j-glow/naped_manipulatora/Modele3d/nakladka/PerformanceLog.txt

Number of Contacts: 0
Number of contact data: 0
