j-glow/naped_manipulatora/Sprawozdanie.docx

# Zakład Podstaw Kontrukcji

# ITLiMS, MEiL, PW

Podstawy Konstrukcji Robotów

Rok akademicki 2022/2023, semestr zimowy

Napęd manipulatora

Sprawozdanie z procesu projektowego

Autor

Jakub Głowacki

# 1 Wstęp

Napęd przeznaczony jest do poruszania jednym przegubem manipulatora w robocie. Jest on mobilny, bardzo uniwersalny z powodu przyłącz jedynie do części ruchomej przegubu, a do podstawy poprzez parę obrotową, przez co cała konstrukcja jest wahliwa. Nie przywidziane zostały w konstrukcji trudne warunki atmosferyczne, dlatego zastosowanie jest zależne od obudowy pełnego robota, lub w przypadku jej braku do zastosowań do środka, takich jak magazyny, czy linie produkcyjne.

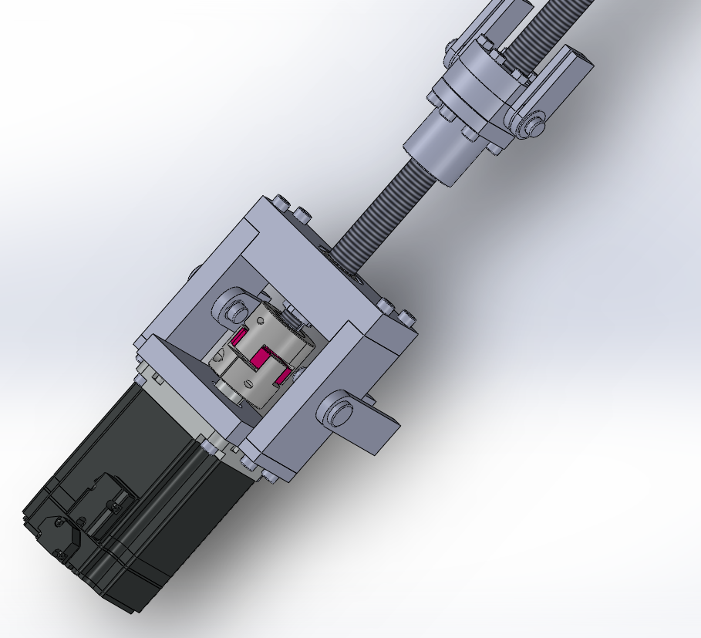
[picture p1: figure]
Obraz zawierający lego, zabawka Opis wygenerowany automatycznie

Rysunek 1 - wizualizacja modelu napędu

# 2 Założenia

Proces projektowy został zdefiniowany przez rysunek poglądowy oraz właściwości dynamiczne i geometryczne przedstawione poniżej.

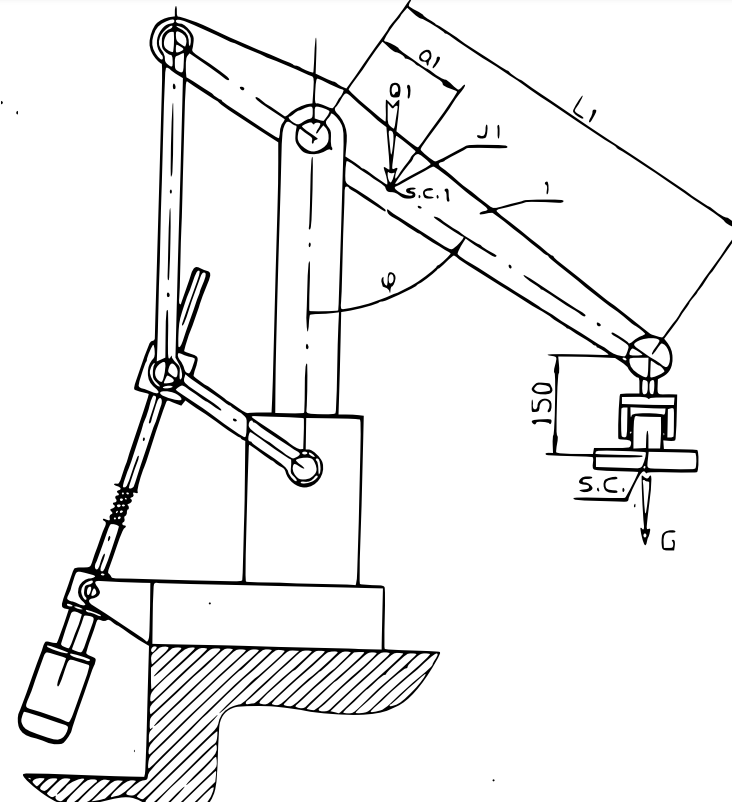
[picture p2: figure]

Rysunek 2 - rysunek poglądowy działania napędu

Wartości liczbowe:

- L1 = 750 mm
- Q1 = 450 mm
- G = 80 N
- J1 = 8.4 kgm²
- φ ϵ (25,105) °
- Ɛ = 7 rad/s²

# 3 Schemat kinematyczny oraz dynamika

## 3.1 Schemat Kinematyczny

W celu wstępnej analizy możliwych rozwiązań stworzyłem prosty schemat kinematyczny manipulatora (Rysunek 2).

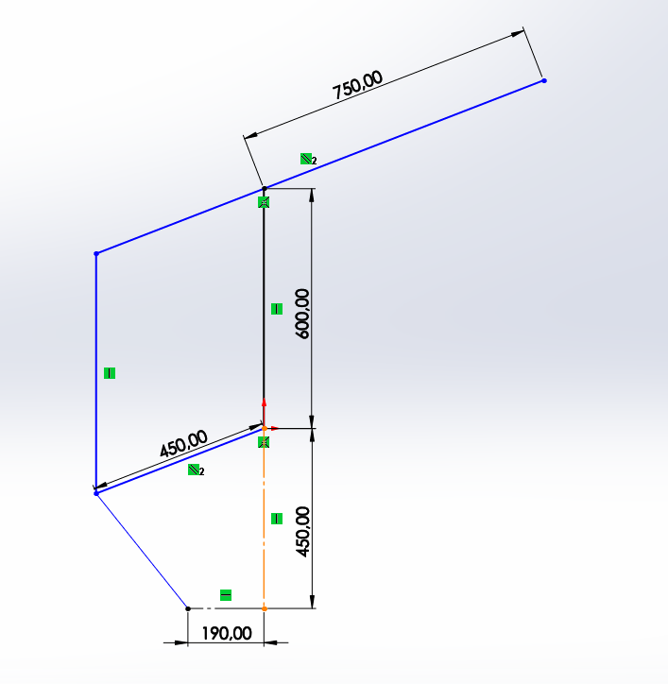
[picture p3: figure]

Rysunek 3 - schemat kinematyczny

Ze względu na brak niektórych danych musiałem je w pewien sposób założyć. Po kilku iteracjach obliczeń w środowisku MATLAB doszedłem do wymiarów widocznych powyżej. Dzięki temu, że długość krótszego cięgna jest równa ramieniowy manipulatora, zachowujemy pionowość cięgna dłuższego, co znacznie upraszcza nam obliczenia. Dodatkowo przy założeniu odległości między punktem obrotu kołyski a pionowym stelażem manipulatora równej 190, uzyskujemy wykres sił w kształcie paraboli o wierzchołku niedaleko środka przedziału kątów pracy. Wiąże się z tym minimalizacja momentu potrzebnego do założonego działania napędu. Ostatnim plusem jest ciągle wychylenie śruby pociągowej w jedną stronę, co umożliwia zaprojektowanie kołnierza z parą obrotową odsuniętą od osi symetrii śruby.

## 3.2 Dynamika

W celu dobrania silnika wymagane są obliczenia dotyczące dynamiki układu. Punktem elementarnym w tych rozważaniach będzie suma momentów wokół punktu obrotu ramienia manipulatora, która oczywiście musi wynosić zero. Schemat sił działających na to ramię w trakcie ruchu przedstawiam poniżej. (Rysunek 3)

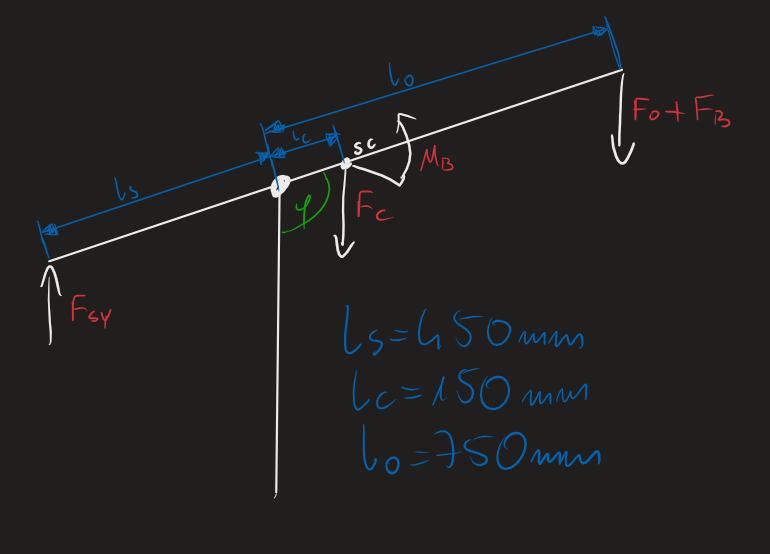
[picture p4: figure]
Obraz zawierający tekst, sygnalizacja uliczna Opis wygenerowany automatycznie

Rysunek 4 – siły i geometria

Zakładam, że na ramię manipulatora działają następujące siły i momenty:

- Mb - moment ze względu na przyspieszenie obrotowe
- Fc - siła ciężkości ramienia
- Fo - siła ciężkości obciążenia
- Fb - siła bezwładności obciążenia
- Fsy - pionowa składowa siły napędowej konstrukcji

Przechodzę więc do obliczenia każdej z nich.

W pierwszej kolejności obliczam moment bezwładności ze wzoru:

M_b =Iε

Gdzie z twierdzenia Steinera moment bezwładności będzie się równał:

I=I_1 +m_r *l_c^2

Gdzie mr to masa ramienia, którą możemy obliczyć z siły ciężkości:

F_c =m_r *g

m_r =(F_c)/g

Następnie mamy siłę obciążenia, która jest stała, ale z niej możemy policzyć masę obciążenia która nam będzie potrzebna do policzenia siły bezwładności.

m_o =(F_o)/g

F_b =m_o *a=m_o *l_o *ε

Mając wszystko policzone możemy przejść do sumowania momentów w celu wyznaczenia siły w cięgnach. Jako że nasz robot ma mieć możliwość pełnych możliwości w pełnym zakresie ruchu, zakładamy najtrudniejszy przypadek – dla każdego kąta wychylenia każda siła działa w przeciwnym kierunku niż siła napędowa:

sinφF_(sy) *l_s =sinφ*(F_c *l_c +(F_o +F_b )*l_o )+M_b

Po odpowiednich przekształceniach i podstawieniu dostajemy ostateczny wzór funkcji siły w zależności od kąta:

F_(sy) (φ)=(F_c *l_c +(F_c +m_o *l_o *ε)*l_o +((I_1 +m_r *l_c^2 )*ε)/(sinφ))/(l_s)

Zadanie obliczeniowe można jednak podzielić na dwie części. Z jednej strony mamy równowagę momentów w ramieniu, co już policzyliśmy, a z drugiej przekazywaną siłę (a na końcu jedynie jej pionową składową) od silnika na koniec ramienia roboczego. Możemy więc narysować schemat wokół węzła w parze obrotowej między kołnierzem a cięgnami.

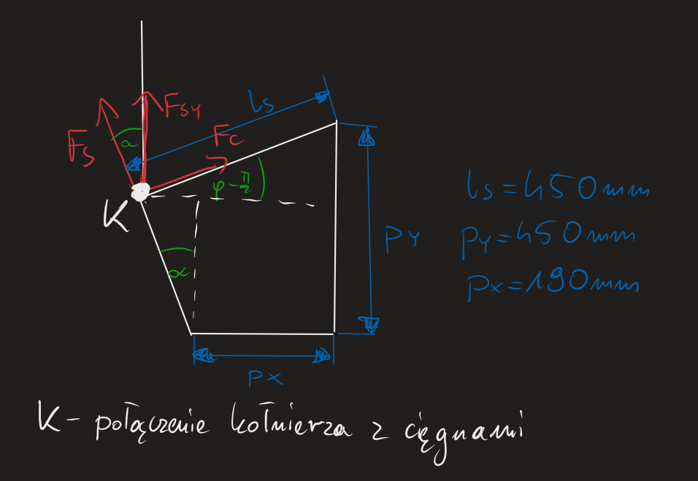
[picture p5: figure]

Rysunek 5 - równowaga sił w węźle

W celu obliczenia siły Fsy możemy skorzystać z równowag sił w osi X i Y dla węzła K:

∑ F_x =F_s *sinα+F_c *cos(φ-π/2)=0

∑ F_y =F_c *sin(φ-π/2)+F_(sy) -F_s *cosα=0

Z pierwszego z tych równań wyliczamy Fc:

F_c =(-F_s *sinα)/(cos(φ-π/2))

A później podstawiamy do drugiego równania i wyliczamy Fs w zależności od Fsy:

F_s =(F_(sy))/(cosα)-(F_s *sinα)/(cos(φ-π/2))*(sin(φ-π/2))/(cosα)

F_s *(1+tanα*tan(φ-π/2))=(F_(sy))/(cosα)

F_s =(F_(sy))/((cosα+sinα*tan(φ-π/2)))

Do znalezienia siły siłownika pozostaje nam tylko wyznaczyć zależność α( φ ):

α=atanx/y=atan((l_s *cos(φ-π/2)-p_x)/(p_y -l_s *sin(φ-π/2)))

Finalnie możemy zobaczyć przebiegi sił Fs oraz Fsy w zależności od kąta. (Rysunek 5)

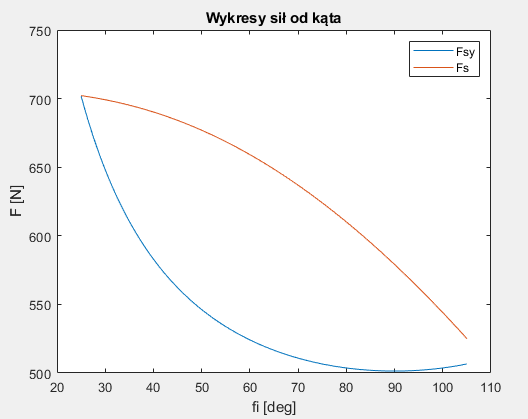
[picture p6: figure]

Rysunek 6 - wykres siły od kąta

Dzięki znajomości siły na śrubie możemy teraz policzyć jaki potrzebny nam jest moment serwonapędu. Wykorzystamy do tego równanie równowagi pracy dla ruchu obrotowego i posuwistego:

W_(obr) =W_(pos)

M_s *2π*n=F_s *d

M_s =(F_s *d)/(2π*n)

Gdzie d to skok śruby (po wypróbowaniu kilku możliwości przyjmujemy 10(mm)/(obr) ), a n to sprawność śruby (w naszym przypadku 90%).

Dodatkowo narzucamy zapas ze względu na możliwe tarcie, nieprzewidzianą dynamikę konstrukcji, oraz unikanie eksploatowania serwonapędu w pełny zakresie możliwości. Zakładając, że chcemy wykorzystywać go tylko w 60% daje nam to wynik:

M_s =(F_s *d)/(2π*n')=2.0695 [Nm]

Ostatnią rzeczą potrzebną nam do wyboru silnika jest jego maksymalna prędkość obrotowa. Większość silników ma maksymalne możliwe obroty równe 3000rpm, a uwzględniając wymagane przyspieszenie ramienia jesteśmy w stanie wszystko przeliczyć.

Prędkość obrotowa silnika, uwzględniając skok śruby d=10mm, przekłada się na prędkość liniową końca ramienia w następujący sposób:

V=ω_s *d

Co dalej daje nam następującą maksymalną prędkość obrotową ramienia:

ω_r =V/(l_s)*(2π)/60=6,98(rad)/s

Aby osiągnąć tą prędkość z przyspieszeniem ε=7(rad)/(s^2) potrzebujemy więc tyle czasu:

t=(ω_r)/ε≅1s

Pokonując jednocześnie w tym czasie kąt o mierze:

φ=1/2*ε_r *t^2 =3,5 rad≫80°

Jak widać wynik jest znacznie większy od naszego pełnego kąta ruchu, więc można założyć profil prędkości trójkątny – połowę drogi przyspieszamy, połowę natomiast hamujemy.

Czas przyspieszania (hamowania) będzie więc równy:

φ=1/2*ε_r *t^2

t=√((2φ)/(ε_r))=0,63s

Jesteśmy skoro tak w stanie wyznaczyć profile prędkości ramienia, które prezentują się następująco:

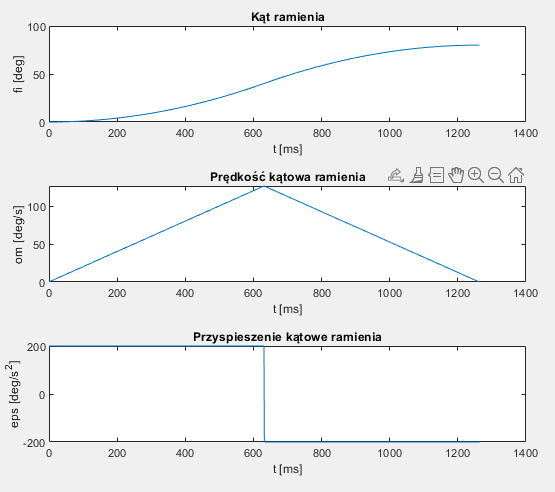
[picture p7: figure]

Rysunek 7 - profile dla ramienia

Obliczam teraz te same wartości dla silnika. Wartości będą te w stosunku do siebie jak długość ramienia do skoku śruby, a więc:

ε_s =ε_r *(l_s)/d

ω_s =ω_r *(l_s)/d

φ_s =φ_r *(l_s)/d

Mając te informacje jesteśmy w stanie stworzyć wykresy opisujące kinematykę silnika oraz śruby:

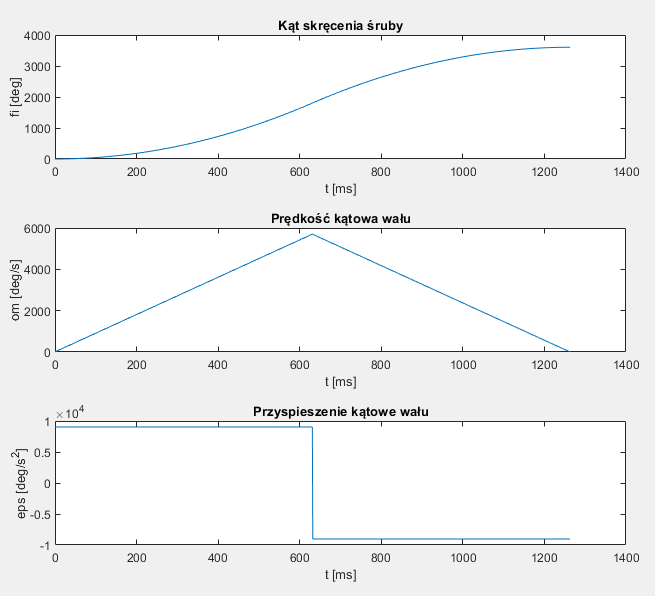
[picture p8: figure]

Rysunek 8 - profile dla śruby/wału

# 4 Dobór części

## 4.1 Serwonapęd

Po przeanalizowaniu wyników jestem w stanie dobrać serwonapęd. Wybieram koniecznie taki, który będzie miał wbudowany enkoder, aby móc w przyszłości odpowiednio nim sterować. Wybór padł na markę HIWIN, model EM1-C-M-75-2. Dokładna specyfikacja dostępna jest w załączniku.

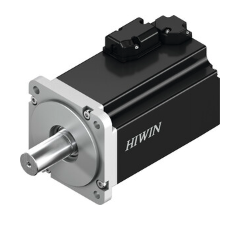
[picture p9: figure]

Rysunek 9 - serwonapęd

## 4.2 Śruba z kołnierzem

Wcześniej założony skok śruby wynikał z procesu iteracyjnego, w którym wygrała śruba kulowa również marki HIWIN. Z analizy schematu kinematycznego można się dowiedzieć, że śruba powinna mieć 857mm długości, dlatego przyjmuję jej długość na 900mm, aby mieć zapas na montaż kołnierzy. Śruba kupowana jest od razu z pasującymi dwoma kołnierzami, jednak obrabiana będzie przez nas samodzielnie.

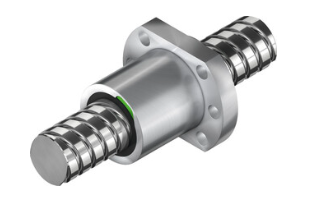
[picture p10: figure]
Obraz zawierający jasne Opis wygenerowany automatycznie

Rysunek 10 - śruba wraz z kołnierzem

Śruba stopniowana będzie kolejno na 15mm średnicy, a następnie na 12mm, co pozwala nam dobrać łożyska, oraz sprzęgło.

## 4.3 Sprzęgło

Ze względu na średnicę wałów serwonapędów oraz śruby do wyboru mieliśmy jedynie dwa sprzęgła kłowe, lub dorobić element rozszerzający wał śruby. Wybór padł jednak na sprzęgło EKL/20/A/12/19, które ma możliwość kupienia z wymaganymi wymiarami. Dodatkowo, przenosi ono momenty znacznie przekraczające wymagane 2.39 Nm.

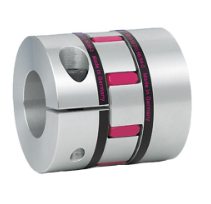
[picture p11: figure]

Rysunek 11 – sprzęgło

## 4.4 Łożyska

Średnica wału 15mm pozwala nam już na użycie łożysk stożkowych, które będą idealne ze względu na odporność na siły osiowe. Wybór pada na firmę SKF.

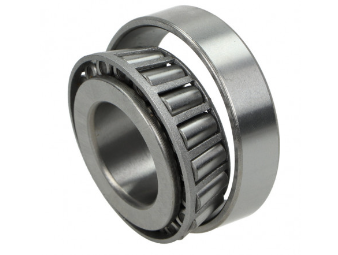
[picture p12: figure]
Obraz zawierający wyroby metalowe, czarny, sprzęt Opis wygenerowany automatycznie

Rysunek 12 - łożysko

# 5 Wytrzymałość elementów

## 5.1 Cięgna

Siła w cięgnie krótszym jest zawsze mniejsza niż w cięgnie długim, więc obliczenia będę przeprowadzał jedynie dla tego drugiego przypadku. Z wcześniejszych obliczeń wiemy że:

F_(sy) (φ)=(F_c *l_c +(F_c +m_o *l_o *ε)*l_o +((I_1 +m_r *l_c^2 )*ε)/(sinφ))/(l_s)≤700N

Mogę więc obliczyć naprężenia ściskające/rozciągające w cięgnie, siłę krytyczną wyboczenia, oraz wymaganą grubość sworznia.

### 5.1.1 Sworznie

Materiałem sworznia będzie stal nierdzewna 316l, co daje nam granicę plastyczności równą R_e =200MPa . Dodatkowo siła rozkłada się na dwa różne cięgna, więc przyjmuje połowę mniejszą siłę.

Przyjmuje model wytrzymałościowy sworznia według schematu poniżej:

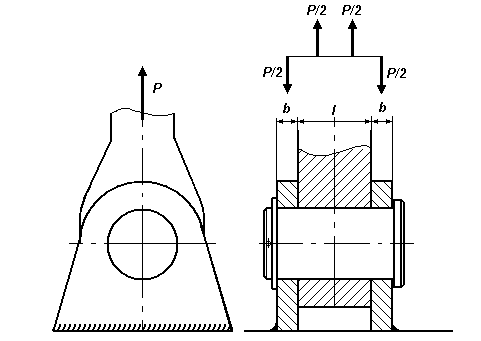
[picture p13: figure]

Rysunek 13 - połączenie sworzniowe luźne

- P=(F_(Symax))/2=350N - siła w cięgnie
- b=3mm - grubość ucha
- l=14mm - grubość cięgna
- k_g =0,5Re=100MPa - maksymalne naprężenia w sworzniu

Wzór na naprężenia wyraża się następująco:

σ_g =(Mg)/(W_x)=(4P*(2b+l))/(π*d^3)<k_g

Co można przekształcić na wzór na minimalną grubość sworznia:

d≥³√((4P*(2b+l))/(π*k_g))=4,47mm

Uwzględniając warunki konstrukcyjne oraz współczynnik bezpieczeństwa przyjmuje jednak grubość sworznia równa 12mm.

Znając materiał ucha (stal konstrukcyjna S355, Re=470MPa), możemy obliczyć minimalną grubość ucha:

p=P/(d*b)≤k_d =0,5R_e

b≥P/(d*0,5R_e)= 0,3mm

Czyli 3mm grubości ucha jest wystarczające.

### 5.1.2 Tuleje ślizgowe

Według normy katalogowej tuleje te mogą wytrzymać naprężenia ściskające równe 78MPa. W celu sprawdzenia wytrzymałości przyjmuję model, w którym cała siła obciążająca rozkłada się równomiernie na ¼ obwodu. Wektory skierowane są wzdłuż promieni. Obszar, na który przypadać będzie siła ściskająca można wyznaczyć wzorem:

A=1/4*π*d_(zew) *l*n

Gdzie:

- d_(zew) =14mm – średnica zewnętrzna
- l=1mm – długość tulei
- n=2 – ilość tulei w jednym połączeniu

Wraz ze wzorem na naprężenia ze względu na ściskanie dostajemy następujące wyniki:

σ=F/A=(4P)/(π*d_(zew) *l*n)=7,96 MPa

Wyliczone naprężenia nie przekraczają granicy wytrzymałości elementu.

### 5.1.3 Ściskanie/rozciąganie

Naprężenia ze względu na rozciąganie/ściskanie wyrażają się wzorem:

σ_r =F/A<k_r =0,5R_e

Przyjmuje dane materiałowe dla stali konstrukcyjnej S355, a przekrój poprzeczny za prostokąt o wymiarach 5mm x 24mm .

σ_r =P/(a*b)=2,9MPa≪k_r

### 5.1.4 Wyboczenie

W przypadku ściskania występuje możliwość wyboczenia. Możemy rozpatrzeć dwa przypadki. Pręt zamocowany w dwóch podstawach obrotowych dla zginania w płaszczyźnie XY, oraz pręt zamocowany z dwóch stron w ścianie dla zginania w płaszczyźnie XZ. Schemat cięgna widać na rysunku 6.

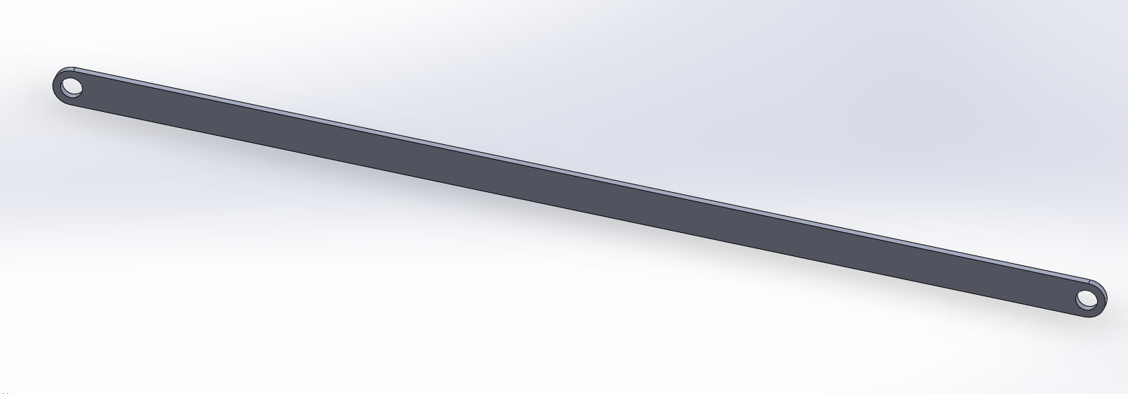
[picture p14: figure]
Obraz zawierający piła, narzędzie Opis wygenerowany automatycznie

Rysunek 14 - cięgno długie

Siłę wybaczającą krytyczną opisujemy wzorem:

P_(kr) =(π^2 *E*I)/(l_s^2)

Dla tego przypadku mamy następujące wartości:

- E=2*10^5 MPa - moduł Younga
- b=5mm - grubość przekroju poprzecznego
- h=24mm - szerokość przekroju poprzecznego
- I_z =(b*h^3)/12=5760 mm^4 - moment bezwładności dla osi Z
- I_y =(b^3 *h)/12=250 mm^4 - moment bezwładności dla osi Y
- l_(sy) =l=650mm - długość swobodna dla wyboczenia w stronę osi Y
- l_(sz) =0,5l=325mm - długość swobodna dla wyboczenia w stronę osi Z

Z czego możemy policzyć siłę krytyczną dla obu przypadków:

P_(maxy) =1168 N>700N

P_(maxz) =108kN≫700N

Skąd widać, że wyboczenie nie wystąpi.

## 5.2 Nakładka na kołnierz

W celu przeniesienia napędu posuwistego na obrotowy stosujemy nakładkę z połączeniem sworzniowym do cięgien, przykręcaną śrubami do kołnierza. Ze względu na trudną geometrię, ale prosty rozkład sił zdecydowałem się na analizę MES. Materiałem nakładki jest stal konstrukcyjna S355.

### 5.2.1 Warunki brzegowe oraz siatka

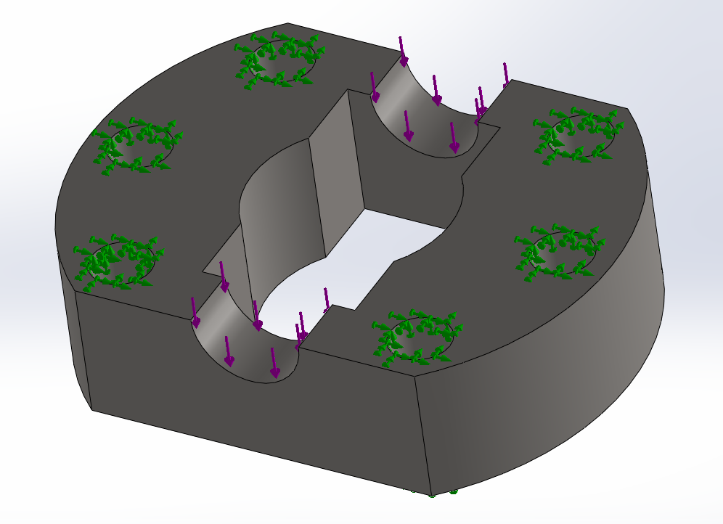
[picture p15: figure]
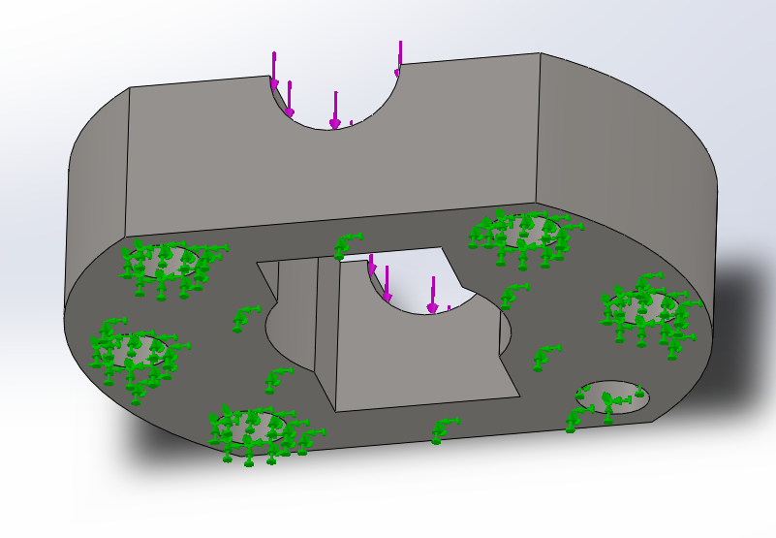
[picture p16: figure]

Nakładka największe obciążenia przenosi podczas gdy kąt wychylenia ramienia manipulatora równy jest 25°. Można uznać że jest to wtedy dokładnie 700N rozłożone między oba sworznie, a wektor skierowany jest pionowo w dół. Korzystając z narzędzia obciążenie łożyska nakładam obciążenie. Jednocześnie ze względu na połączenia śrubowe oraz kontakt spodu z kołnierzem nakładam warunki nieruchomej geometrii na spód nakładki oraz wzdłuż powierzchni walcowych w dziurach na śruby. Całość widoczna jest na rysunku.

Rysunek 15 - ograniczenie ruchu (zielone) oraz siły zewnętrzne (fioletowe)

Siatkę generuje automatycznie przy pomocy wbudowanej opcji w oprogramowaniu SolidWorks.

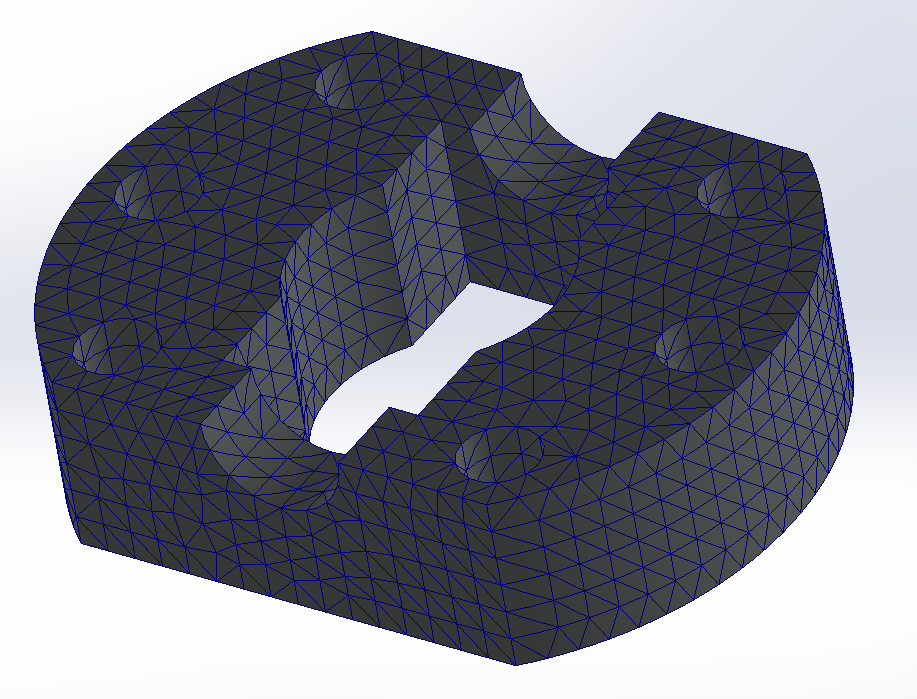
[picture p17: figure]
Obraz zawierający tekst Opis wygenerowany automatycznie

Rysunek 16 – siatka

### 5.2.2 Wyniki

Wyniki naprężeń i przemieszczeń prezentują się następująco.

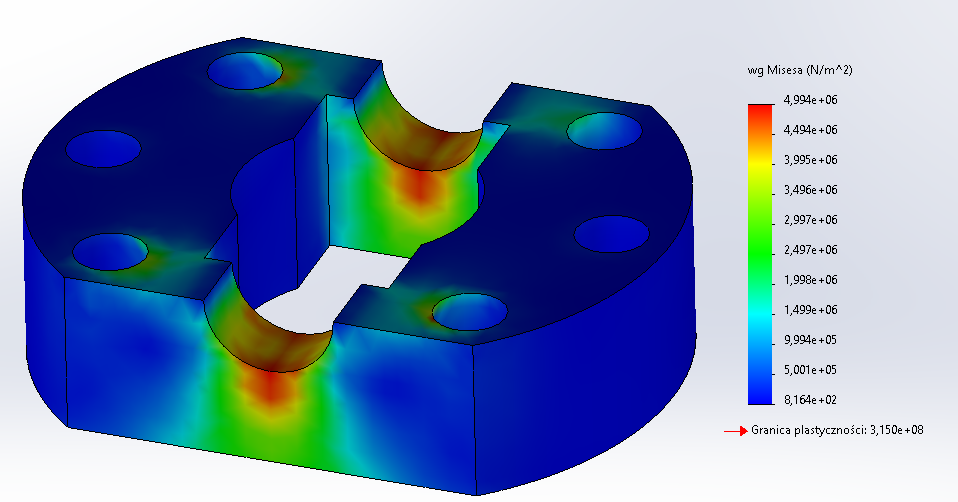
[picture p18: figure]

Rysunek 17 - wykres naprężeń

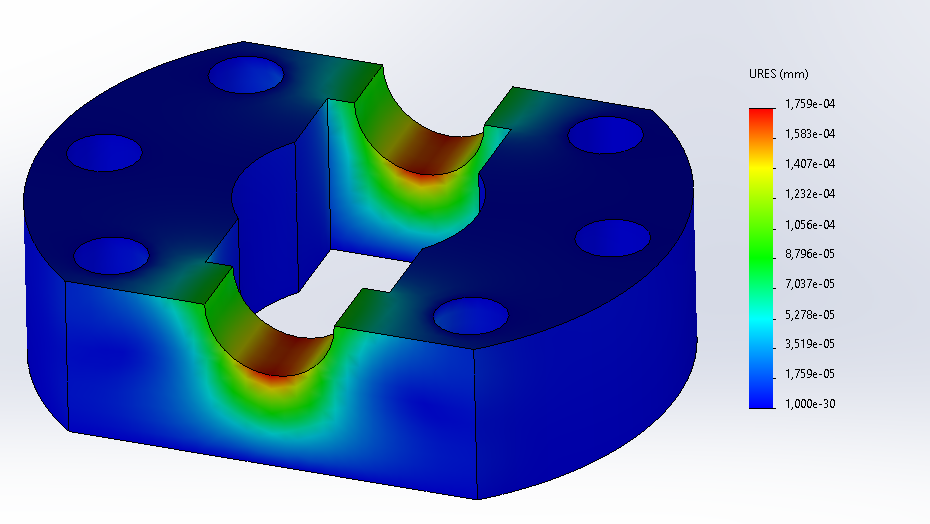
[picture p19: figure]

Rysunek 18 - wykres przemieszczeń

Jak widać naprężenia maksymalne wynoszą około 5MPa w dolinie otworu na sworzeń, co jest bardzo oddalone od granicy plastyczności równej 275MPa, a przemieszczenia są 3 rzędy mniejsze od milimetra, czyli pomijalnie małe. Część uznaje za bezpieczną.

### 5.2.3 Sworznie nakładki

Z powodu jednostronnego umocowania sworznia należy wybrać inny model

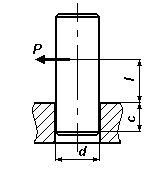
[picture p20: figure]

Rysunek 19 - model sworznia utwierdzonego jednostronnie

Suma geometryczna sił działających na sworzeń jest zawsze równa sile z jaką śruba będzie działała na kołnierz. W najgorszym wypadku jest to 700N, a żeby mieć pewność co do wytrzymałości, zakładam że cała siła odkłada się na dalszym z cięgien. W takim wypadku dane mają się następująco:

- P=(F_(Symax))/2=350N - siła w cięgnie
- c=7mm - grubość utwierdzenia
- l=10mm - grubość cięgna
- k_g =0,5Re=100MPa - maksymalne naprężenia w sworzniu

Minimalną średnicę sworznia wyliczam ze wzoru:

σ_g =(Mg_(max))/(W_x)=(P*(l+c/2))/((πd^3)/32)≤k_g

Czyli po przekształceniu:

d≥³√((32*P*(l+c/2))/(π*k_g))=7,83mm

czyli, skoro średnica sworznia wynosi 12mm, wytrzyma on w każdym momencie pracy.

## 5.3 Śruba

Śruba powinna zostać policzona ze względu na możliwość wyboczenia. Najniebezpieczniejszym momentem występuje gdy ramię manipulatora jest wychylone o kąt 25°, ponieważ wtedy siły powstają największe. Śrubę modeluję jako belkę okrągłą, o jednym końcu utwierdzonym bez wstępnego kąta ugięcia, a drugi koniec jako swobodny.

Siłę wybaczającą krytyczną opisujemy wzorem:

P_(kr) =(π^2 *E*I)/(l_s^2)

Dla tego przypadku mamy następujące wartości:

- E=2*10^5 MPa - moduł Younga
- d=17 mm - grubość przekroju poprzecznego
- I=(πd^4)/64=4100 mm^4 - moment bezwładności
- l=800 mm - długość zginana śruby
- l_s =2*l=1600 mm - długość swobodna dla wyboczenia

Z czego możemy policzyć siłę krytyczną:

P_(max) =3161 N>700N

Skąd widać, że wyboczenie nie wystąpi.

## 5.4 Łożyska

Łożyska będą obciążane głownie osiowo, obciążenia promieniowe są praktycznie pomijalne. Maksymalne obciążenia w łożysku równe będą obciążeniom w śrubie.

Aby obliczyć równoważne obciążenie statyczne łożyska wykorzystamy wzór:

P=X*P_p +Y*P_w

Dla naszego łożyska, wartości dobrane z tabel zawartych w normach:

- X=0
- Y=2,11
- P_p =0
- P_w =700N

Wartość równoważnego obciążenia jest więc równa:

P=1477 N<C_0 =20,8 kN

czyli łożysko wytrzyma.

## 5.5 Kołyska

### 5.5.1 Część górna (łożyskująca)

Górna część kołyski odpowiadająca za łożyskowanie wału będzie przez obciążenie z łożysk, lub przy obciążeniu w drugą stronę rozciągane będą śruby montażowe M6.

Aby obliczyć naprężenia w śrubach dzielimy siłę po równo między cztery śruby, za średnicę bierzemy średnicę trzpienia śruby, a następnie obliczamy ze wzoru:

σ=F/A=(4F)/(πd^2)=9,79 MPa

Czyli śruba wytrzyma.

Analizę zginania pokrywy przeprowadzę przy pomocy analizy MES. Umocowanie ustalam jako połączenie przesuwne na pionowych powierzchniach styku z elementem bocznym kołyski, a dolna krawędź otworu na śrubę jako geometria nieprzesuwna. Dodatkowo przykładam siłę powierzchniową w płaszczyźnie styku z górnym łożyskiem.

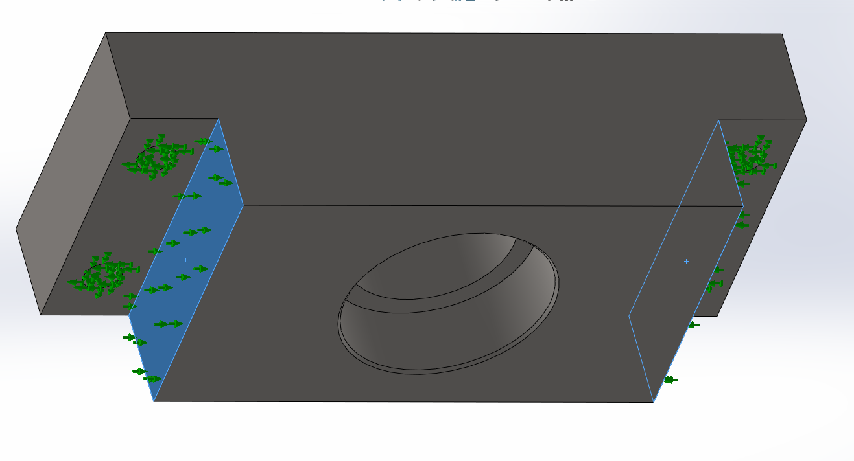
[picture p21: figure]
Obraz zawierający tekst, stacjonarne, akcesorium, koperta Opis wygenerowany automatycznie

Rysunek 20 – mocowania

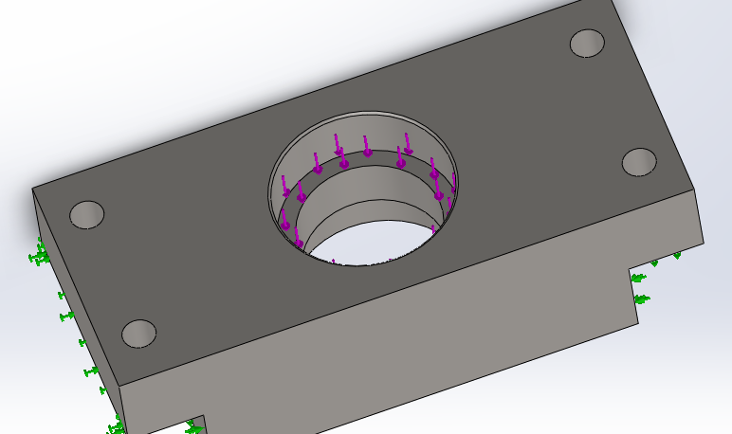
[picture p22: figure]

Rysunek 21 – obciążenie

Siatka generowana automatycznie:

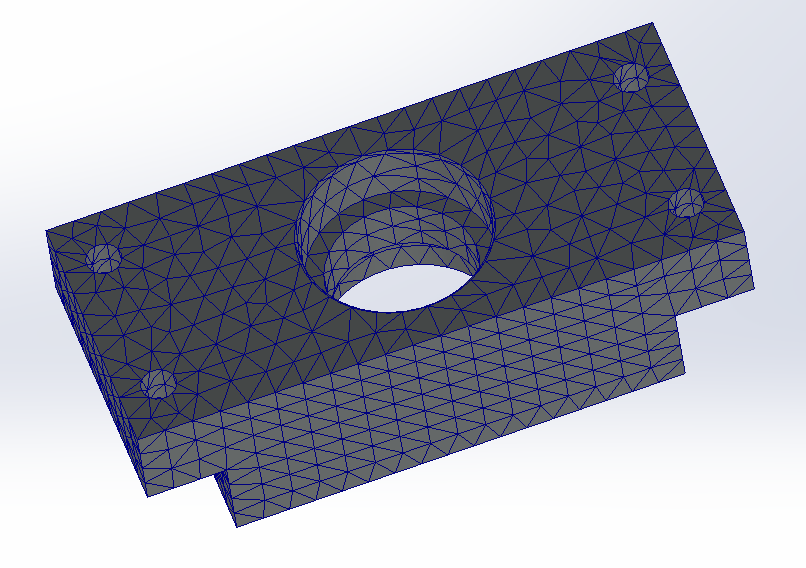
[picture p23: figure]
Obraz zawierający tekst, koperta Opis wygenerowany automatycznie

Rysunek 22 - siatka

Wyniki prezentują się następująco:

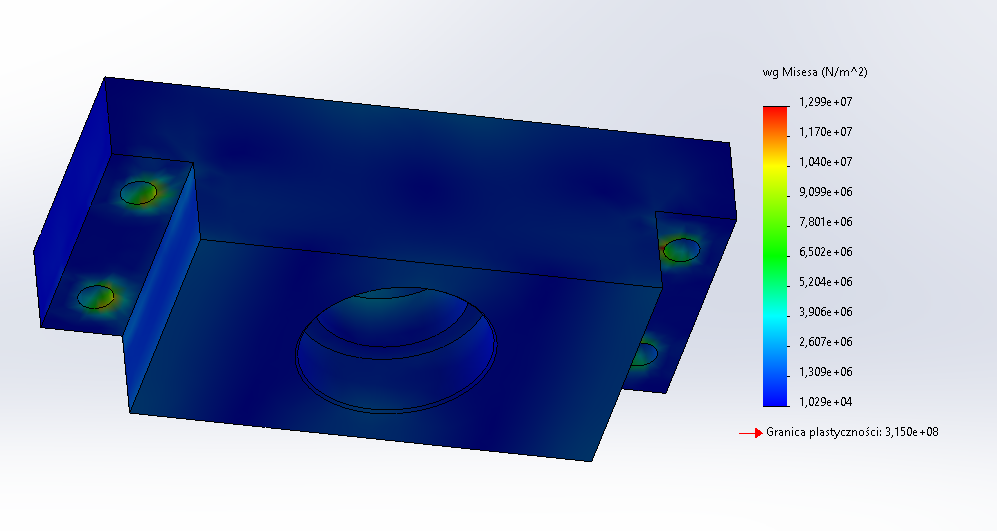
[picture p24: figure]

Rysunek 23 – naprężenia

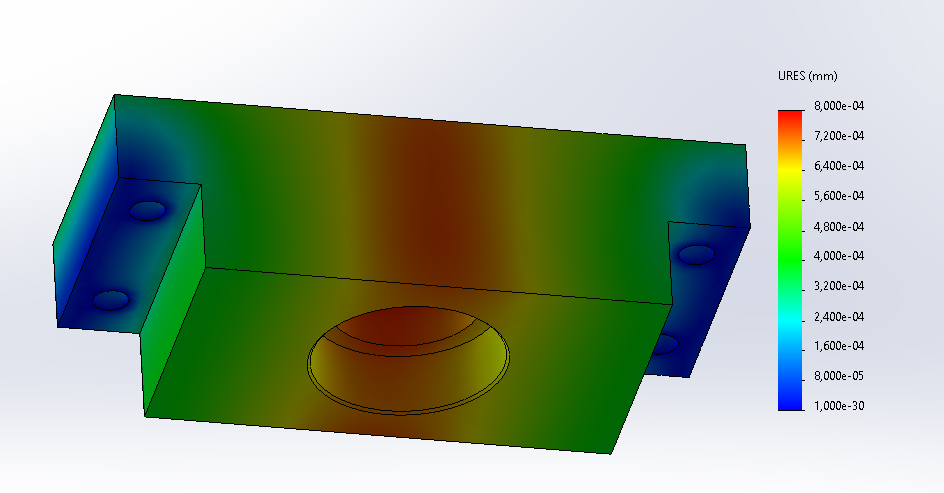
[picture p25: figure]

Rysunek 24 – przemieszczenia

Ponownie jak w przypadku nakładki na kołnierz wyniki są zadowalające – mogą uznać część za bezpieczną.

### 5.5.2 Panel boczny

Sam panel boczny będzie jedynie ściskany w obszarze od górnej części kołyski do sworznia, a później ścinany od silnika. Ze względu na jego wymiary można pominąć analizę wytrzymałościową, bo będą to pomijalnie małe naprężenia. Obliczyć natomiast należy sworzeń mocujący kołyskę oraz tuleje łożyskujące. Zakładam analogiczny model jak w przypadku sworznia nakładki.

Dane:

- P=(F_(Symax))/2=350N - siła nacisku
- b=6,5mm - grubość ucha
- l=15mm - grubość boku kołyski
- k_g =0,5Re=100MPa - maksymalne naprężenia w sworzniu

Czyli minimalna grubość sworznia to:

d≥³√((4P*(2b+l))/(π*k_g))=4.99 mm

Czyli średnica 12mm będzie wystarczająca.

Znając materiał ucha (stal konstrukcyjna S355, Re=470MPa), możemy obliczyć minimalną grubość ucha:

p=P/(d*b)≤k_d =0,5R_e

d≥P/(d*0,5R_e)= 0,29 mm

Czyli ponownie ucho wytrzyma.

## 5.6 Silnik

Ostatnim elementem do przeliczenia będzie montaż silnika. Składa się on z 4 połączeń śrubowych, między silnikiem a podstawą kołyski, a następnie podstawa kołyski przy pomocy takich samych 4 śrub montowana jest do boków kołyski.

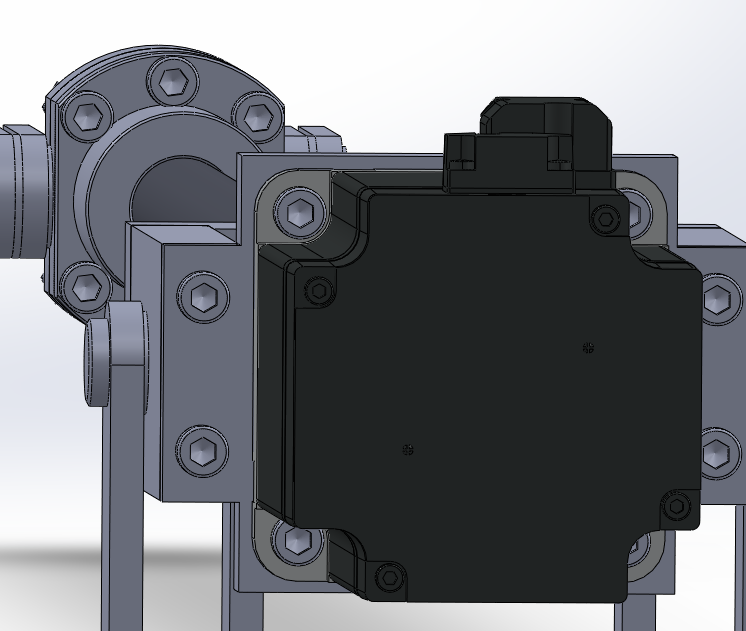
[picture p26: figure]

Rysunek 25 - montaż silnika

Śruby te muszą wytrzymać ścinanie ze względu na moment obrotowy silnika. Bardziej narażone na ścięcie są jednak śruby rozmieszczone na większym okręgu. To one więc będą poddane analizie wytrzymałościowej.

Naprężenia wyliczać będę ze wzoru:

τ=(Q*4)/(π*d^2 *m)

Gdzie:

- M=2.39 Nm - moment skręcający
- r=52 mm - promień okręgu koła na którym rozstawione są śruby
- Q=M/(4r)=46 N - siła ścinająca
- d=4,77 mm - średnica trzpienia śruby
- m=1 - powierzchnie tnące

Daje nam to ostateczny wynik:

τ=0,64MPa

Czyli śruby są bezpieczne.

# 6 Wykonanie elementów

Wszystkie elementy zostaną wykonane w technice frezowania przy pomocy maszyn CNC z bloków stali konstrukcyjnej S355 według rysunków wykonawczych zawartych w załącznikach do sprawozdania.

Z rzeczy wartych dodatkowego wspomnienia jest na pewno własna obróbka śruby HIWIN ze względu na potrzebę dokładnych wymiarów. Dodatkowo wymagany był rowek na powierzchni walcowej gwintowanej, ze względu na montaż podkładki do nakrętki łożyskowej.

Kolejną wartą uwagi czynnością jest wiercenie otworów pasowanych na sworznie w nakładkach kołyski, które winno się odbyć dopiero po skręceniu obu nakładek wraz z kołnierzem przy pomocy śrub M6, aby zapewnić odpowiednią współpracę elementów.

# 7 Montaż

## 7.1 Kołyska

Aby zmontować kołyskę należy w pierwszej kolejności włożyć łożyska stożkowe w odpowiednie otwory pasowane.

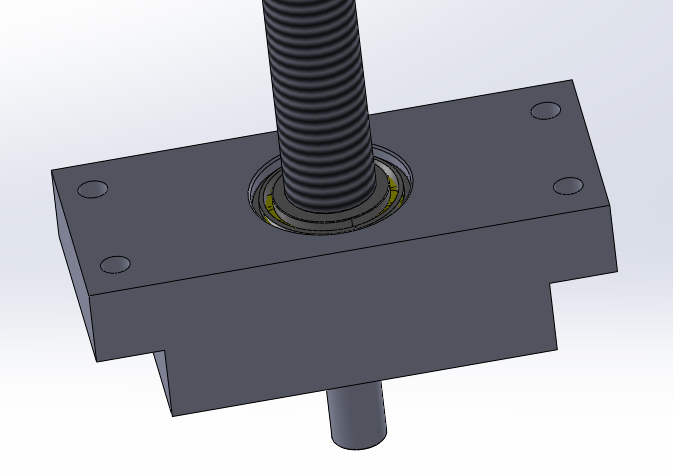
[picture p27: figure]

Rysunek 26 - wał ułożyskowany

Następnie mocujemy w nich wał, który blokujemy z drugiej strony nakładając podkładkę do nakrętki tak, aby jej wpust wszedł w rowek mocujący. Po dokręceniu nakładki należy zagiąć pasujące wypustki nakładki w przygotowane rowki na nakładce.

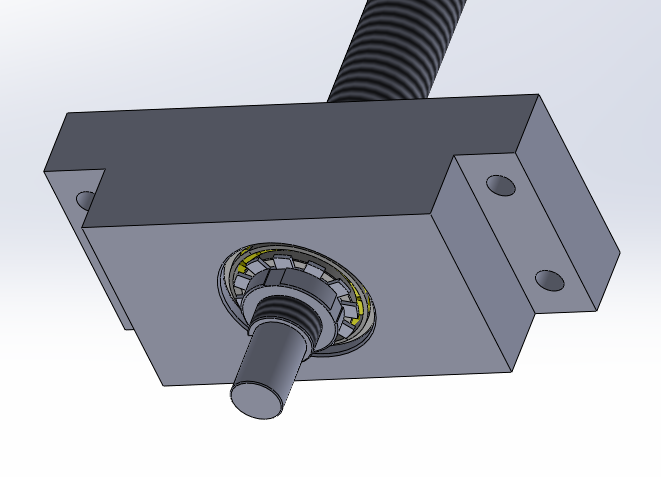
[picture p28: figure]
Obraz zawierający tekst Opis wygenerowany automatycznie

Rysunek 27 - blokada ruchu osiowego śruby

Można następnie założyć sprzęgło kłowe na śrubę.

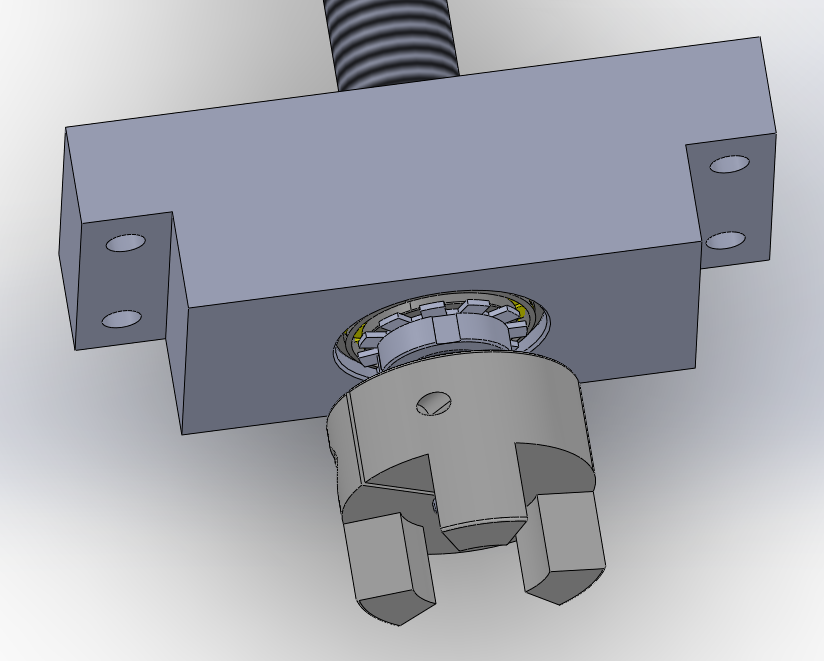
[picture p29: figure]
Obraz zawierający tekst Opis wygenerowany automatycznie

Rysunek 28 - sprzęgło na śrubie

Następnie przykręcamy silnik śrubami do postawy kołyski.

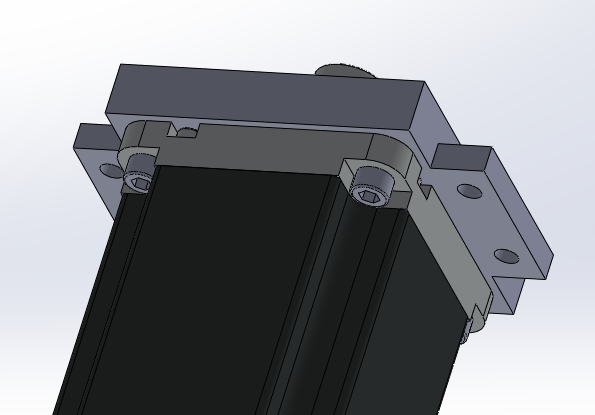
[picture p30: figure]

Rysunek 29 - montaż silnika

W kolejnym kroku łączymy boki kołyski ze stelażem przy pomocy sworzni na które uprzednio nakładamy tuleje ślizgowe, po czym zabezpieczamy pierścieniem Segera.

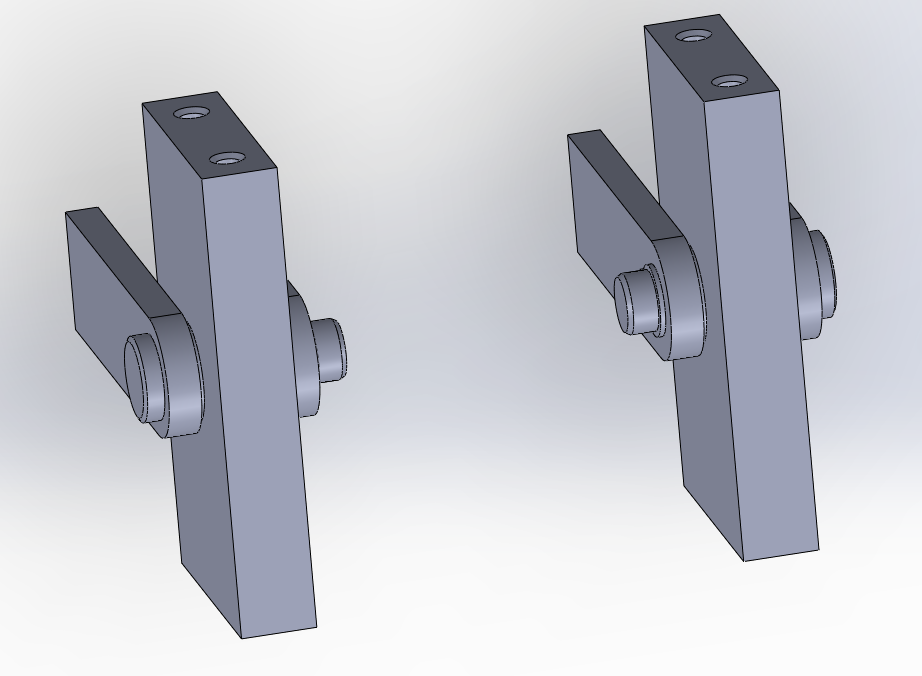
[picture p31: figure]

Rysunek 30 - boki kołyski zamontowane do stelaża

W kolejnym kroku można przykręcić podstawę kołyski wraz z silnikiem do boków. Na wał silnika można zamontować pasujące do średnicy sprzęgło kłowe.

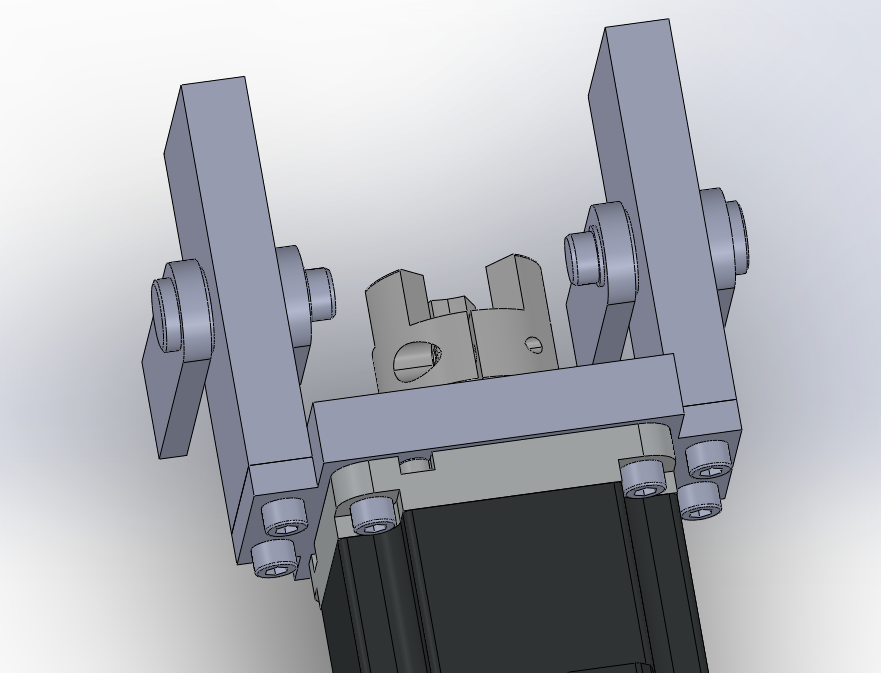
[picture p32: figure]

Rysunek 31 - montaż silnika do kołyski

W kolejnym kroku należy przykręcić górną pokrywę tak, aby łożyska się ze sobą zazębieniu, nie zapominając o włożeniu między nie elementu podatnego.

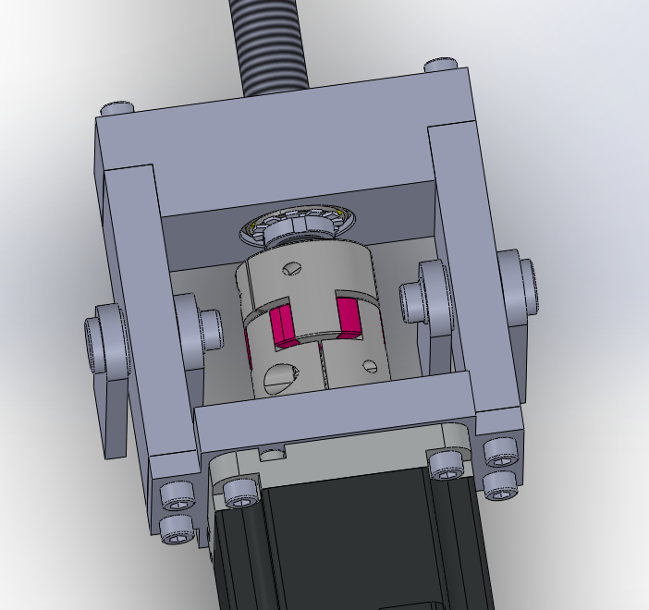
[picture p33: figure]

Rysunek 32 - gotowa kołyska

## 7.2 Przeniesienie napędu śruba-cięgna

W celu montażu przeniesienia napędu należy złożyć ze sobą nakładki kołnierza wraz z kołnierzem i skręcić śrubami. Można wtedy przejść do wiercenia otworu pasowanego na sworzeń.

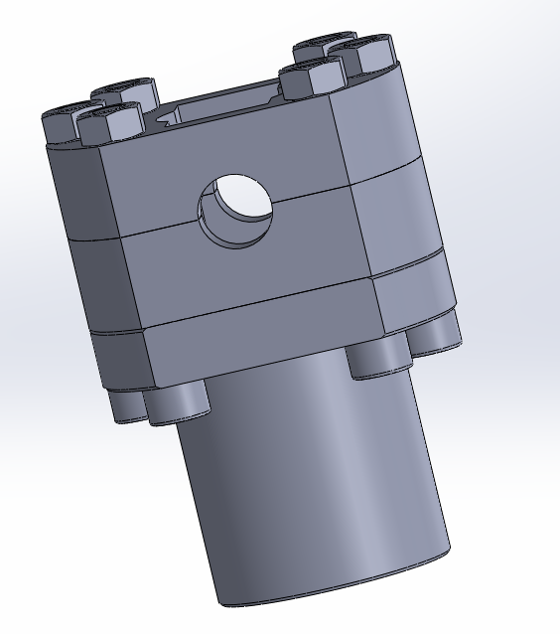
[picture p34: figure]

Rysunek 33 - wiercenie otworu na sworzeń

Po nawierceniu można je rozkręcić, aby ponownie skręcić z włożonymi sworzniami.

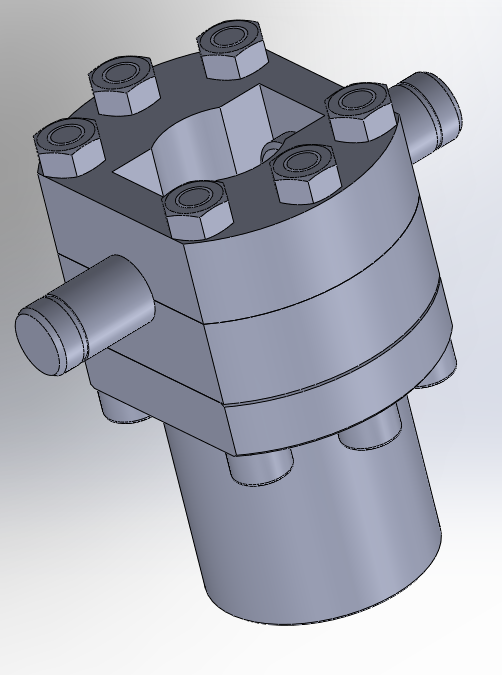
[picture p35: figure]

Rysunek 34 - kołnierz ze sworzniami

Następnie można przejść do montażu kołnierza na śrubie według zaleceń producenta (HIWIN).

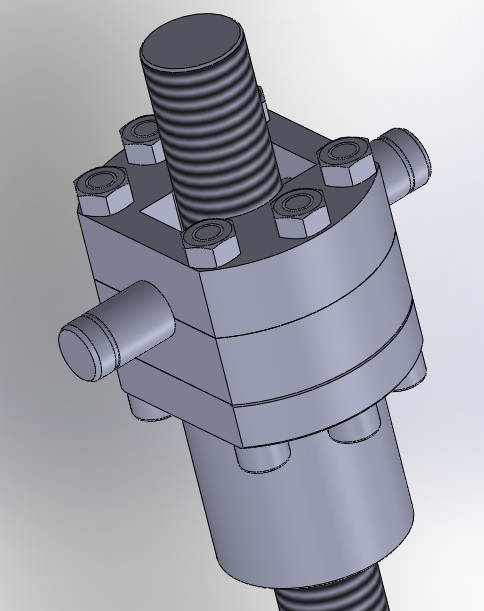
[picture p36: figure]

Rysunek 35 - kołnierz na śrubie

Ostatnim krokiem jest montaż cięgien manipulatora do sworzni kołnierza, pamiętając o uprzednim założeniu tulei ślizgowych. Sworznie blokujemy ponownie pierścieniem Segera.

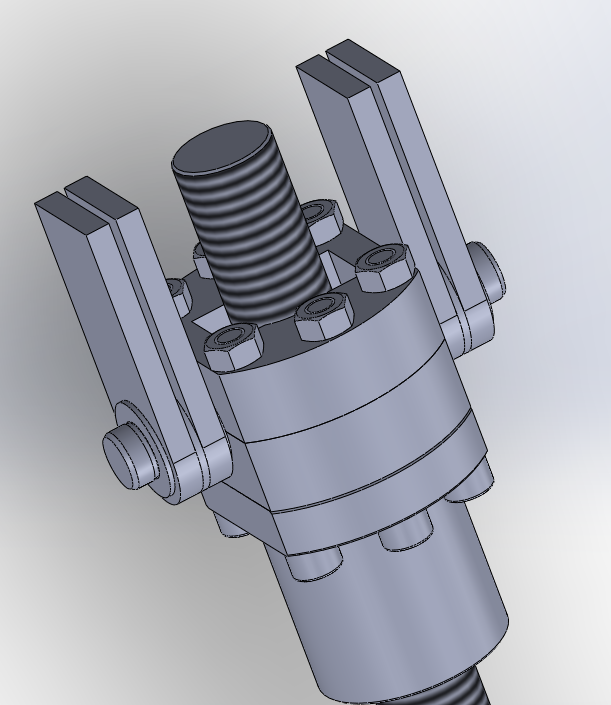
[picture p37: figure]
Obraz zawierający sprzęt Opis wygenerowany automatycznie

Rysunek 36 - gotowy kołnierz

Finalny projekt napędu wygląda w sposób następujący

Rysunek 37 - złożony napęd

# 8 Wnioski

Projektowanie napędu jest zdecydowanie niełatwym zadaniem, głownie dlatego że wymaga dobrego przygotowania merytorycznego oraz obliczeniowego, aby późniejsza konstrukcja miała wysokie możliwości ruchowe.

Osobiście największe trudności w projekcie przyniosło mi projektowanie nakładki na kołnierz, ze względu na brak pomysłu na eleganckie rozwiązanie.

W następnej iteracji projektu na pewno optymalizowałbym punkt obrotu kołyski względem manipulatora, w celu zmniejszenia wymaganego momentu silnika, oraz skrócenia śruby kulowej.

W przypadku modelowania części, następnym krokiem byłoby zabudowanie kołyski, aby ograniczyć możliwości interakcji z częściami podatnymi na uszkodzenia/zabrudzenia.

Dodatkowo w obliczeniach dynamiki chciałbym uwzględnić masę samego napędu wraz z przeniesieniem, aby lepiej odwzorować charakterystykę kinematyczną przegubu.

# 9 Załączniki

- PKR2-JG_00.00
- PKR2-JG_01.00
- PKR2-JG_02.00
- PKR2-JG_03.00
- PKR2-JG_04.00
- HIWIN_Ballscrew_Datasheet
- HIWIN_Servomotor_Datasheet
- SKF_Bearing_Datasheet
- R+W_Clutch_Datasheet
