j-glow/naped_manipulatora/Modele3d/lozysko/SKF_30202.sldasm

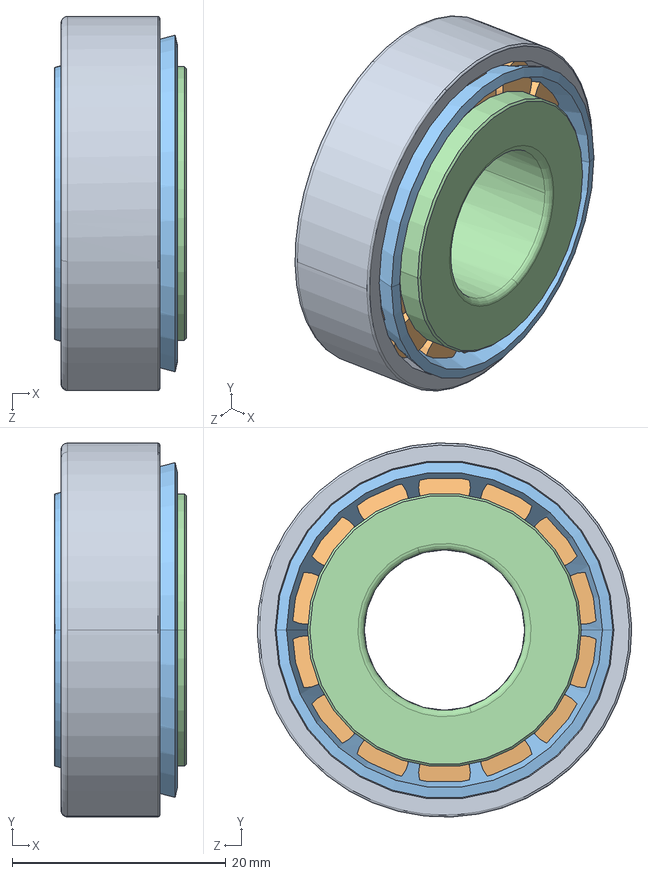
[picture p38: CAD file, 2023-01-25]
Modele3d/lozysko/SKF_30202.sldasm
12.4 x 35.0 x 35.0 mm
SKF_30202_3
SKF_30202_5 x 14
SKF_30202_20
SKF_30202_22
