j-glow/naped_manipulatora/Modele3d/sprzeglo ekl 19 12.SLDASM

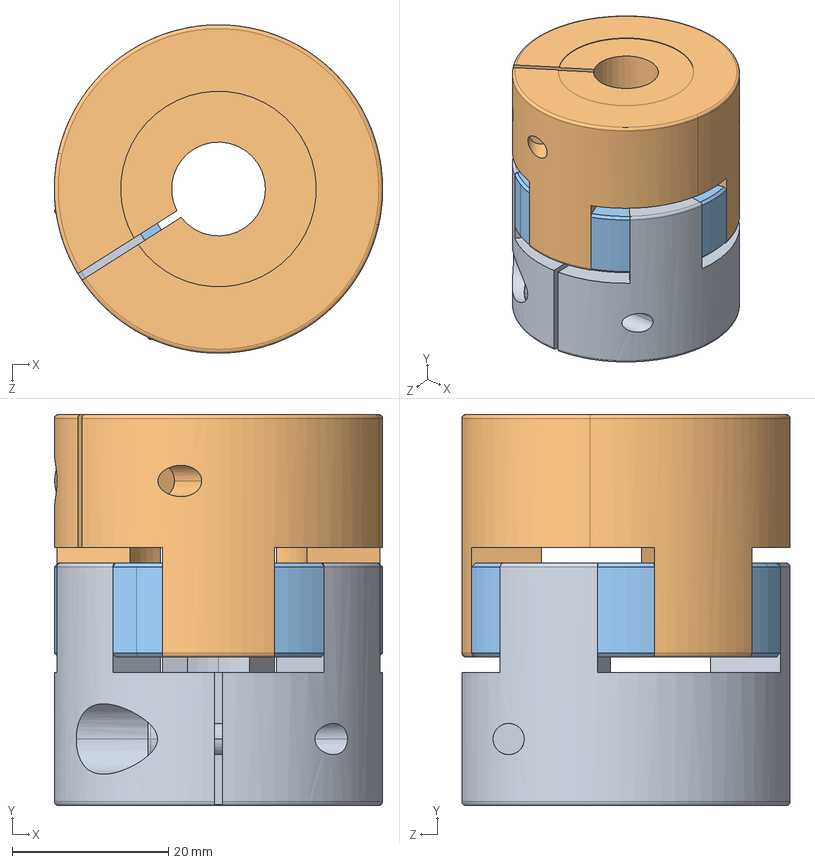
[picture p39: CAD file, 2023-01-25]
Modele3d/sprzeglo ekl 19 12.SLDASM
42.0 x 50.0 x 42.0 mm
3D_EKL_020_Nabe1.STEP
3D_EKL_020_Nabe2.STEP
3D_EKL_020_Stern.STEP
