j-glow/naped_manipulatora/Modele3d/nakretka gotowa.SLDASM

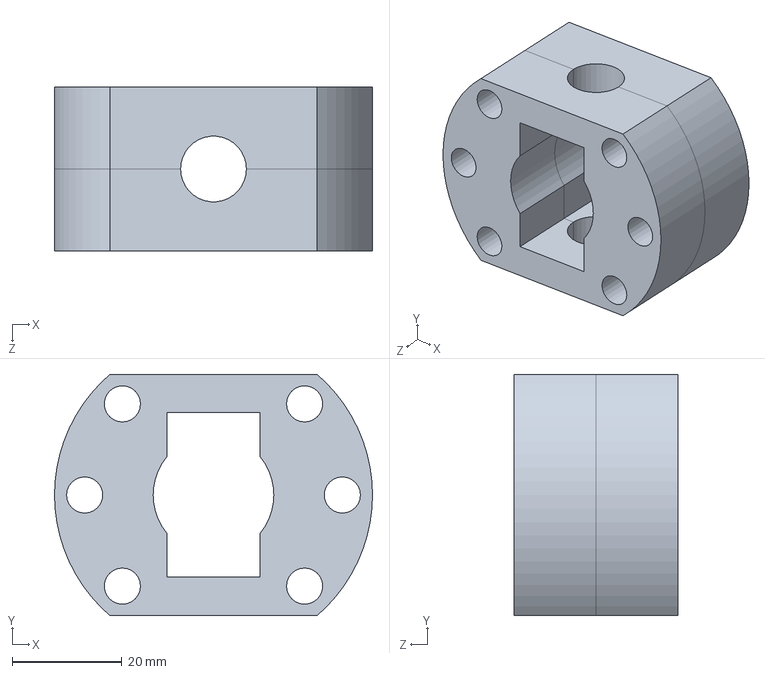
[picture p40: CAD file, 2023-01-25]
Modele3d/nakretka gotowa.SLDASM
58.0 x 44.0 x 30.0 mm
nakladka x 2
