j-glow/naped_manipulatora/Modele3d/kolyska.SLDASM

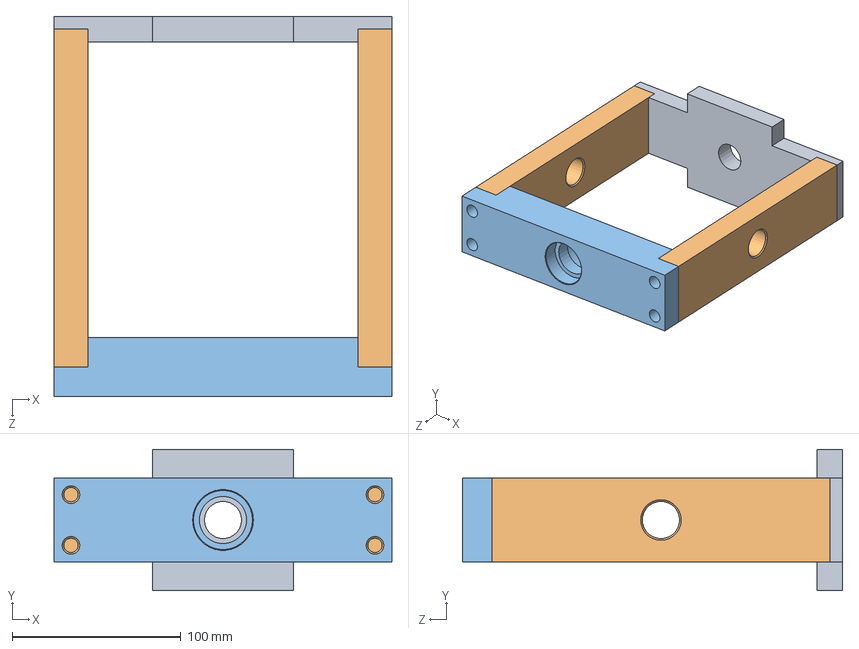
[picture p41: CAD file, 2023-01-25]
Modele3d/kolyska.SLDASM
200.0 x 83.6 x 225.0 mm
kolyska doł
kolyska bok x 2
kołyska gora
