j-glow/naped_manipulatora/Modele3d/Kołnierz.SLDASM

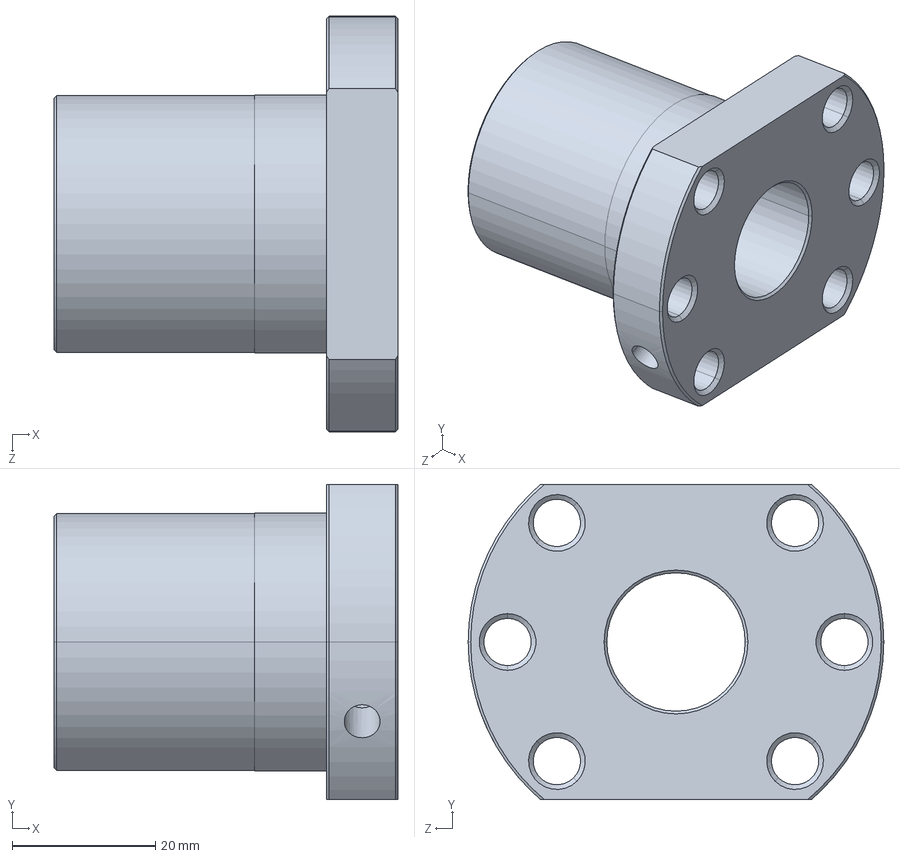
[picture p42: CAD file, 2023-01-25]
Modele3d/Kołnierz.SLDASM
48.0 x 44.0 x 58.0 mm
