j-glow/naped_manipulatora/Modele3d/nakladka/nakladka.SLDPRT

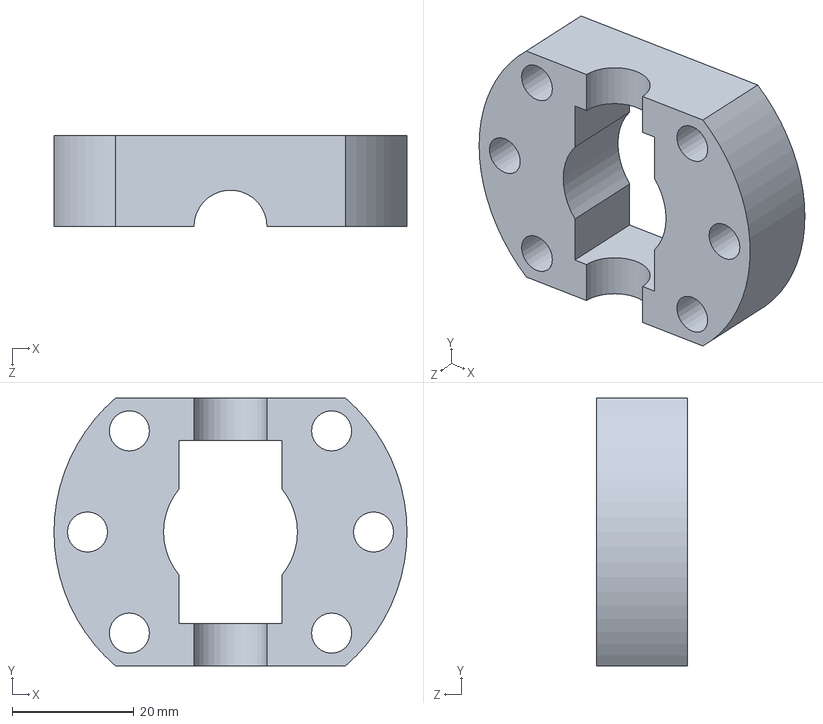
[picture p43: CAD file, 2023-01-25]
Modele3d/nakladka/nakladka.SLDPRT
58.0 x 44.0 x 15.0 mm
