j-glow/naped_manipulatora/Modele3d/pokrywa gorna/kołyska gora.SLDPRT

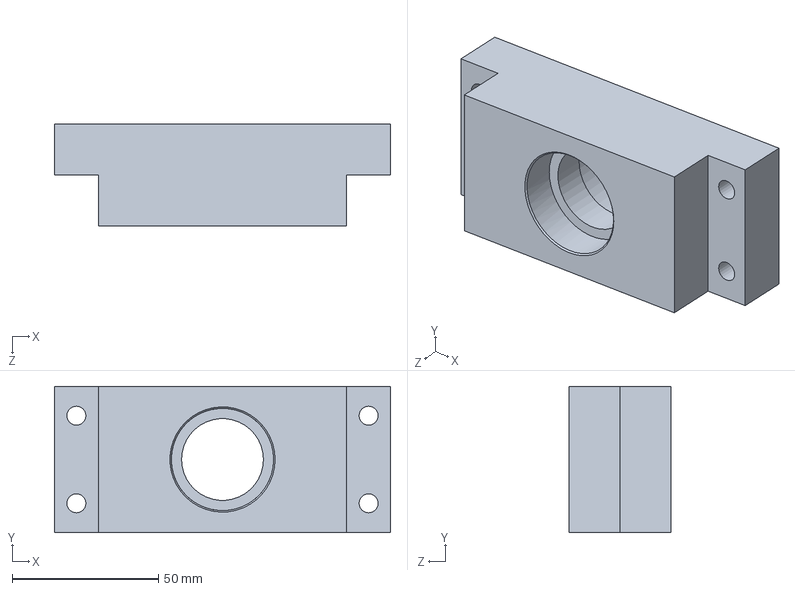
[picture p44: CAD file, 2023-01-25]
Modele3d/pokrywa gorna/kołyska gora.SLDPRT
115.0 x 50.0 x 35.0 mm
