j-glow/naped_manipulatora/Modele3d/seger.SLDPRT

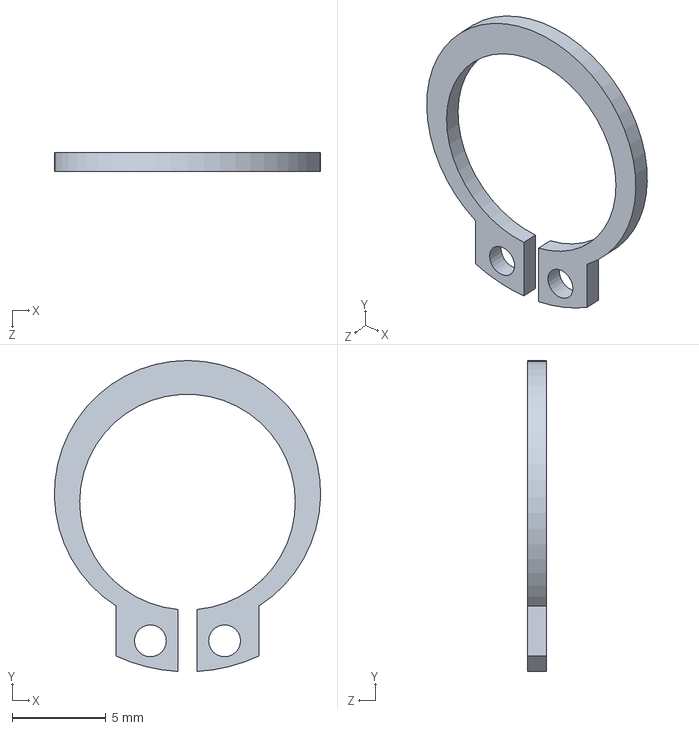
[picture p45: CAD file, 2023-01-25]
Modele3d/seger.SLDPRT
14.2 x 16.6 x 1.00 mm
