j-glow/naped_manipulatora/Modele3d/kn 02 din 981.SLDPRT

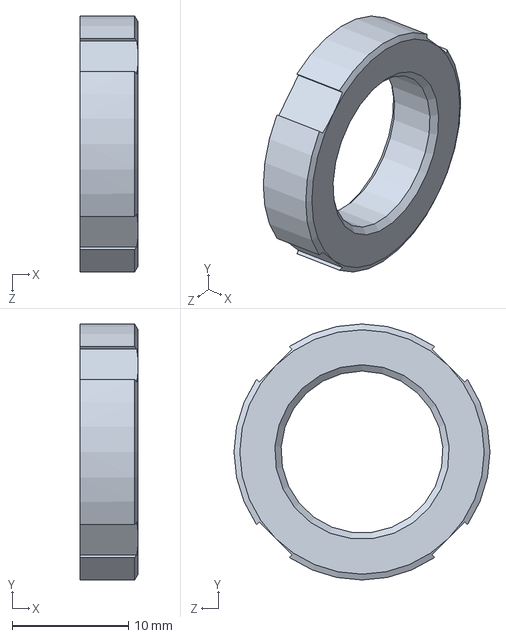
[picture p46: CAD file, 2023-01-25]
Modele3d/kn 02 din 981.SLDPRT
5.00 x 22.0 x 22.0 mm
