j-glow/naped_manipulatora/Modele3d/nakretka m6.SLDPRT

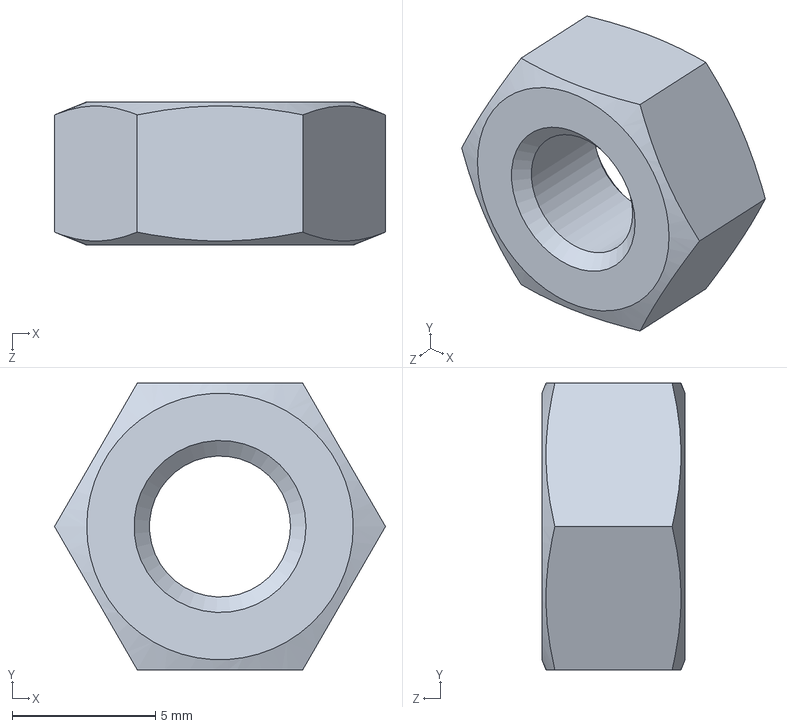
[picture p47: CAD file, 2023-01-25]
Modele3d/nakretka m6.SLDPRT
11.5 x 10.00 x 5.00 mm
