j-glow/naped_manipulatora/Modele3d/sworzen krótki.SLDPRT

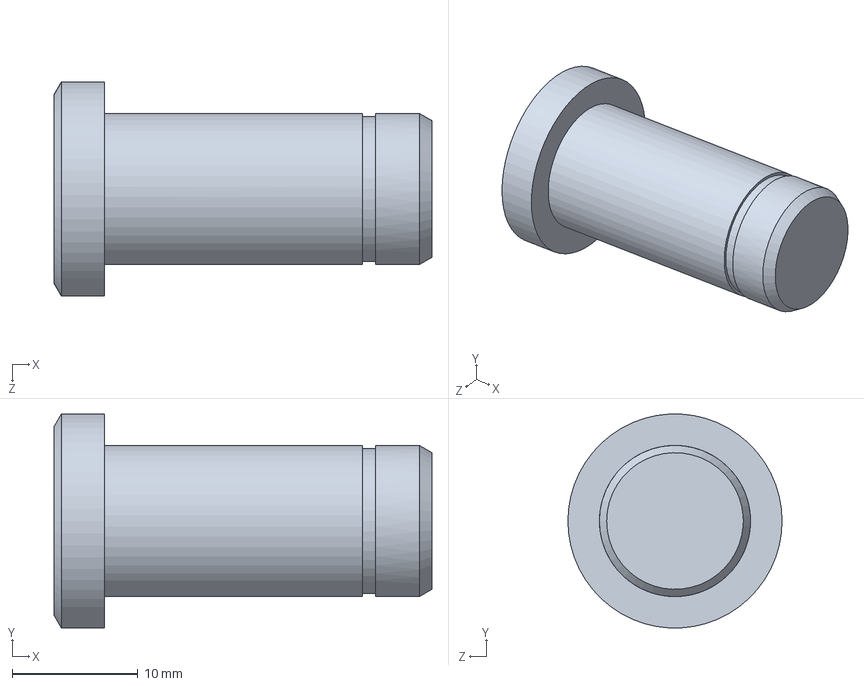
[picture p48: CAD file, 2023-01-25]
Modele3d/sworzen krótki.SLDPRT
30.0 x 17.0 x 17.0 mm
