j-glow/naped_manipulatora/Modele3d/podkladka slizgowa.SLDPRT

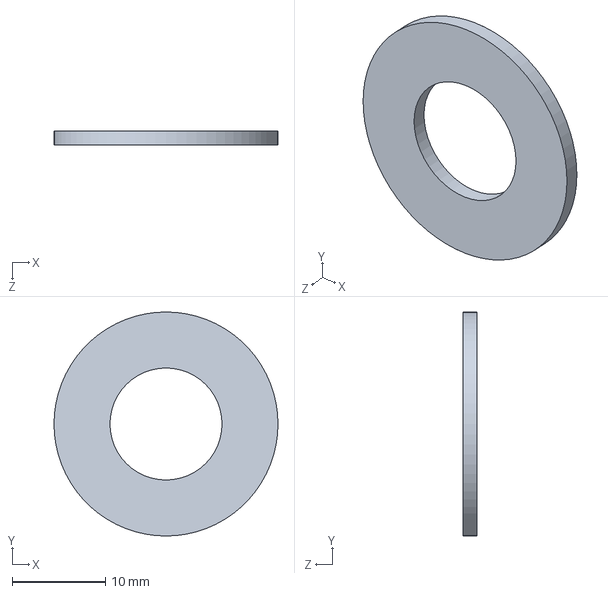
[picture p49: CAD file, 2023-01-25]
Modele3d/podkladka slizgowa.SLDPRT
24.0 x 24.0 x 1.50 mm
