j-glow/naped_manipulatora/Modele3d/podkladka lozysko.SLDPRT

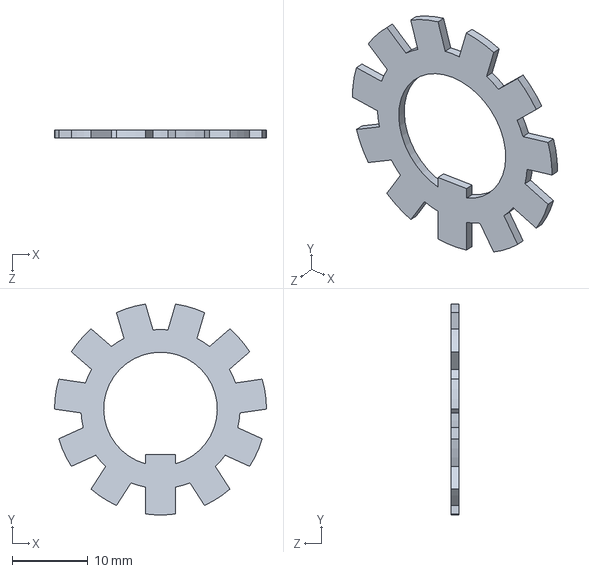
[picture p50: CAD file, 2023-01-25]
Modele3d/podkladka lozysko.SLDPRT
28.0 x 27.8 x 1.00 mm
