j-glow/naped_manipulatora/Modele3d/ucho.SLDPRT

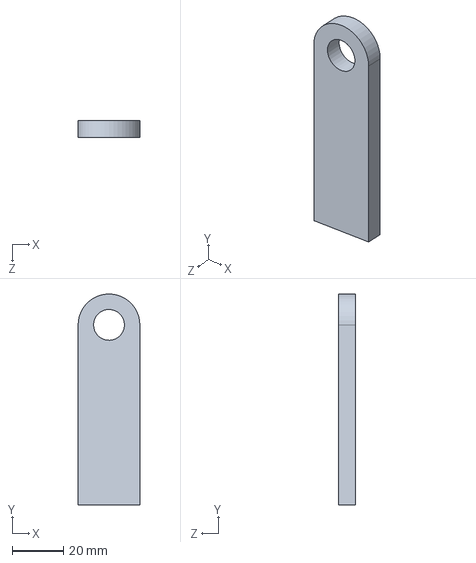
[picture p51: CAD file, 2023-01-25]
Modele3d/ucho.SLDPRT
24.0 x 82.0 x 6.50 mm
