j-glow/naped_manipulatora/Modele3d/tuleja slizgowa.SLDPRT

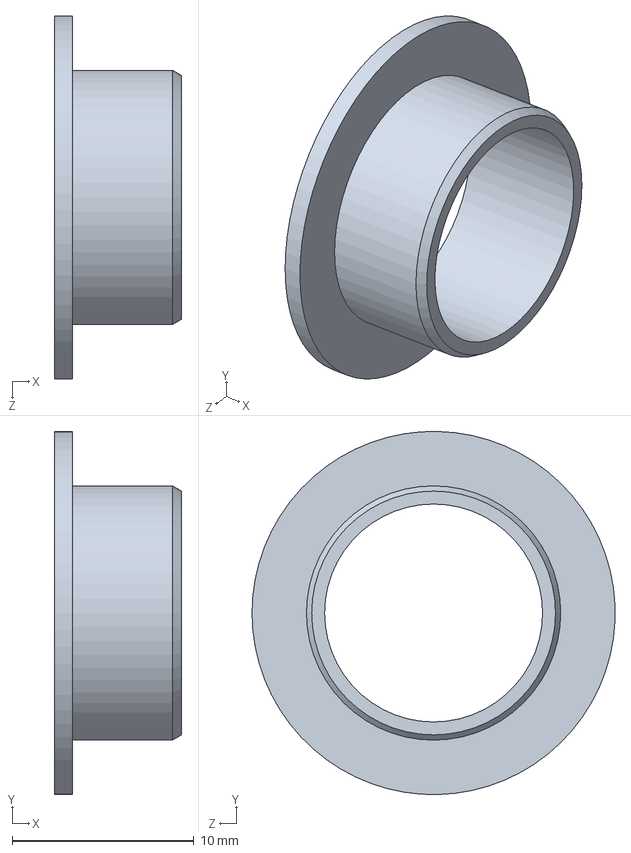
[picture p52: CAD file, 2023-01-25]
Modele3d/tuleja slizgowa.SLDPRT
7.00 x 20.0 x 20.0 mm
