j-glow/naped_manipulatora/Modele3d/m6 nakr.SLDPRT

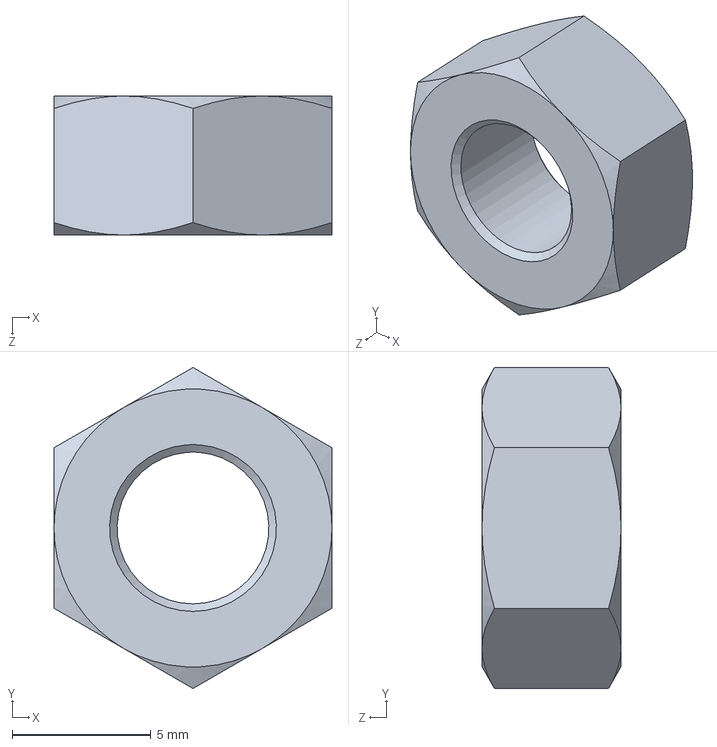
[picture p53: CAD file, 2023-01-25]
Modele3d/m6 nakr.SLDPRT
10.0 x 11.5 x 5.00 mm
