j-glow/naped_manipulatora/Modele3d/kolyska bok.SLDPRT

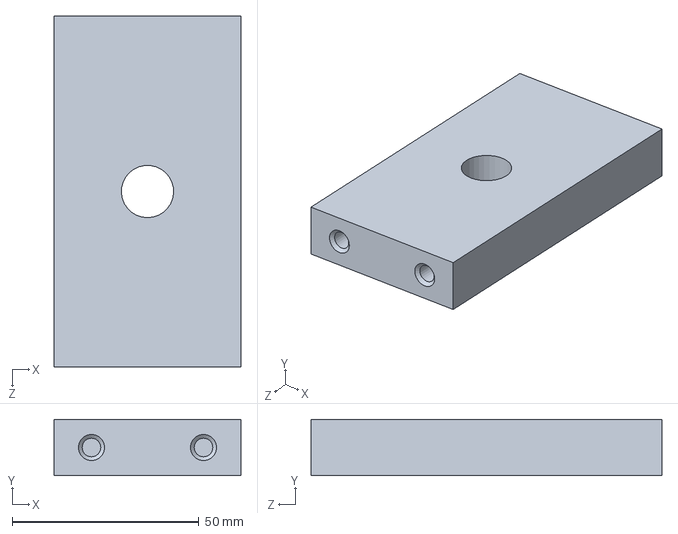
[picture p54: CAD file, 2023-01-25]
Modele3d/kolyska bok.SLDPRT
50.0 x 15.0 x 94.0 mm
