j-glow/naped_manipulatora/Modele3d/ciegno.SLDPRT

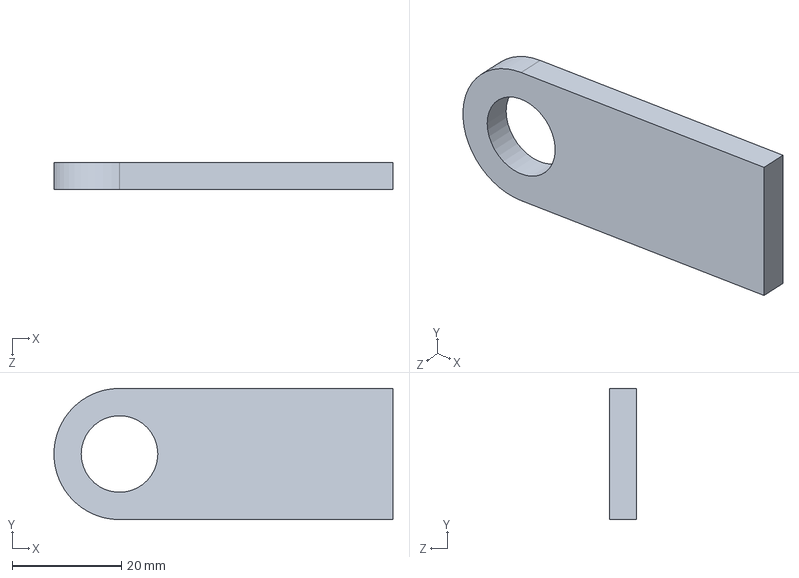
[picture p55: CAD file, 2023-01-25]
Modele3d/ciegno.SLDPRT
62.0 x 24.0 x 5.00 mm
