j-glow/naped_manipulatora/Modele3d/sruba.SLDPRT

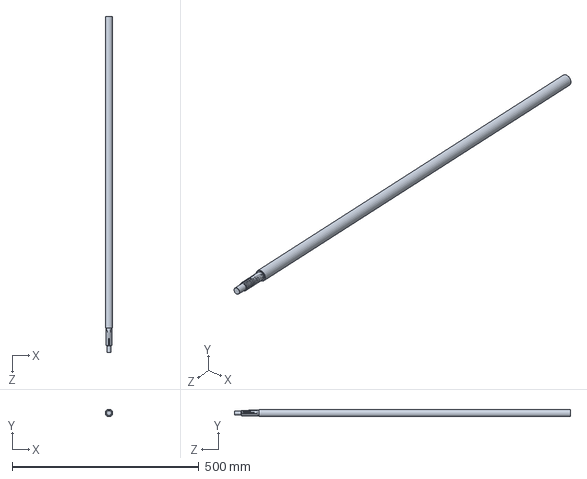
[picture p56: CAD file, 2023-01-25]
Modele3d/sruba.SLDPRT
20.0 x 20.0 x 900.0 mm
