j-glow/naped_manipulatora/Modele3d/tuleja krotka.SLDPRT

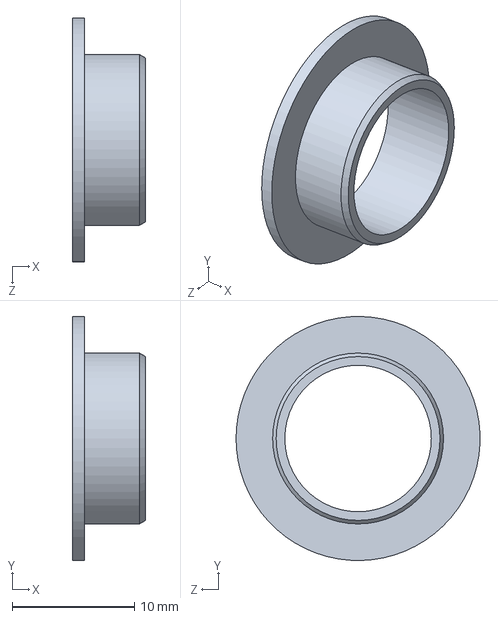
[picture p57: CAD file, 2023-01-25]
Modele3d/tuleja krotka.SLDPRT
6.00 x 20.0 x 20.0 mm
