j-glow/naped_manipulatora/Modele3d/ciegno 650.SLDPRT

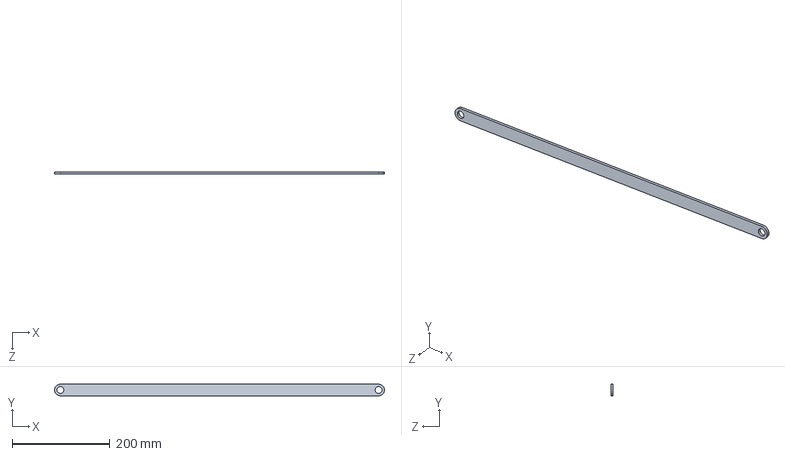
[picture p58: CAD file, 2023-01-25]
Modele3d/ciegno 650.SLDPRT
674.0 x 24.0 x 5.00 mm
