j-glow/naped_manipulatora/Modele3d/kolyska doł.SLDPRT

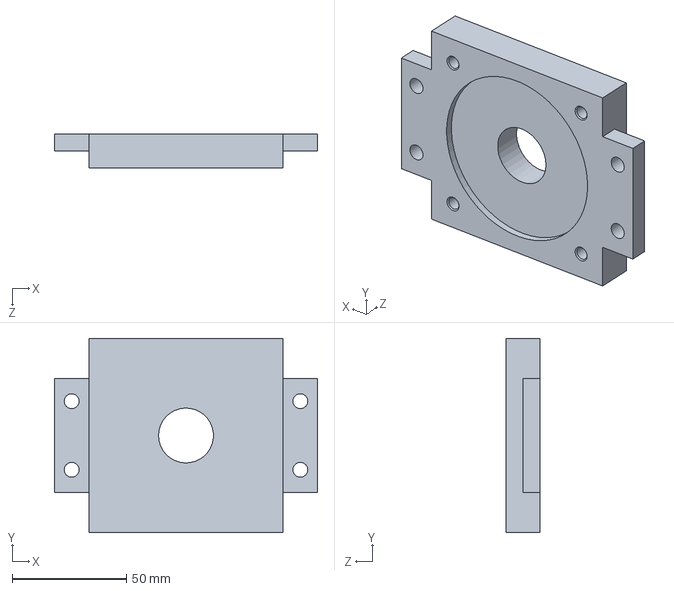
[picture p59: CAD file, 2023-01-25]
Modele3d/kolyska doł.SLDPRT
115.0 x 85.0 x 15.0 mm
