j-glow/naped_manipulatora/Modele3d/sworzen 12x30.SLDPRT

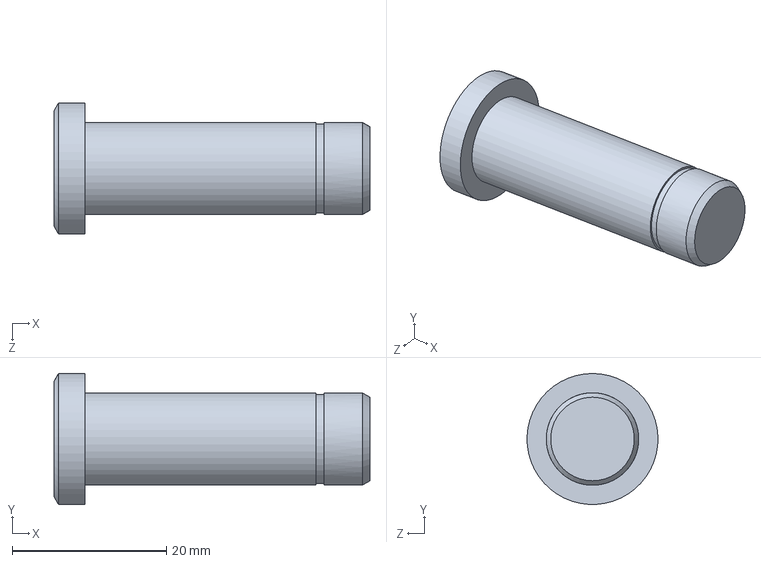
[picture p60: CAD file, 2023-01-25]
Modele3d/sworzen 12x30.SLDPRT
41.0 x 17.0 x 17.0 mm
