j-glow/naped_manipulatora/Modele3d/ciegno 450.SLDPRT

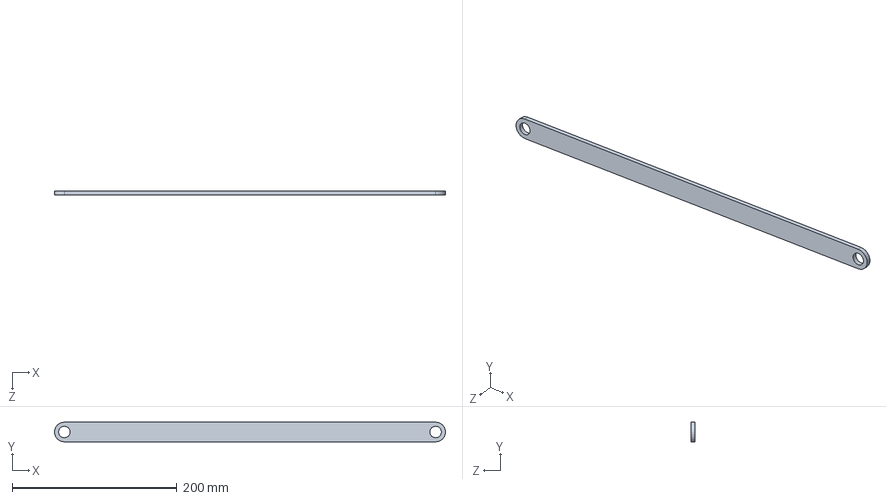
[picture p61: CAD file, 2023-01-25]
Modele3d/ciegno 450.SLDPRT
474.0 x 24.0 x 5.00 mm
