j-glow/naped_manipulatora/Modele3d/stelaz.SLDPRT

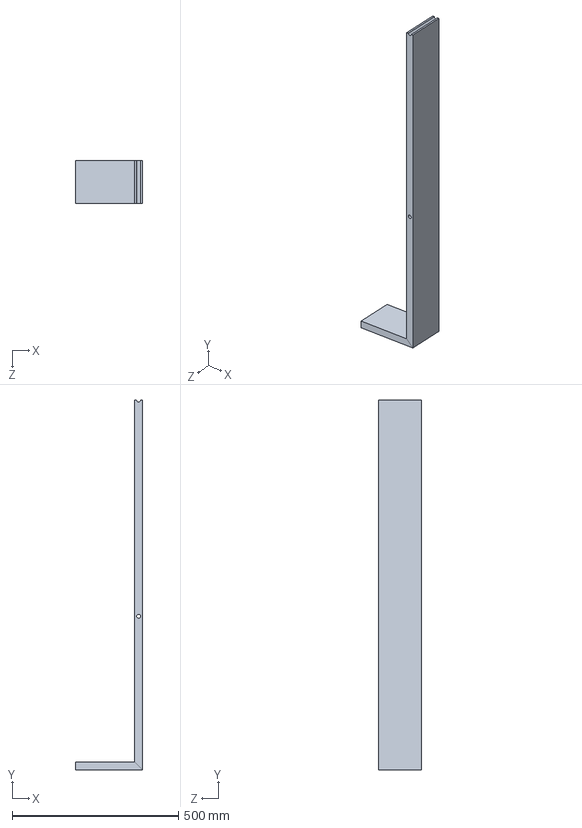
[picture p62: CAD file, 2023-01-25]
Modele3d/stelaz.SLDPRT
202.0 x 1112.0 x 130.0 mm
