j-glow/naped_manipulatora/Modele3d/serwo hiwin.SLDPRT

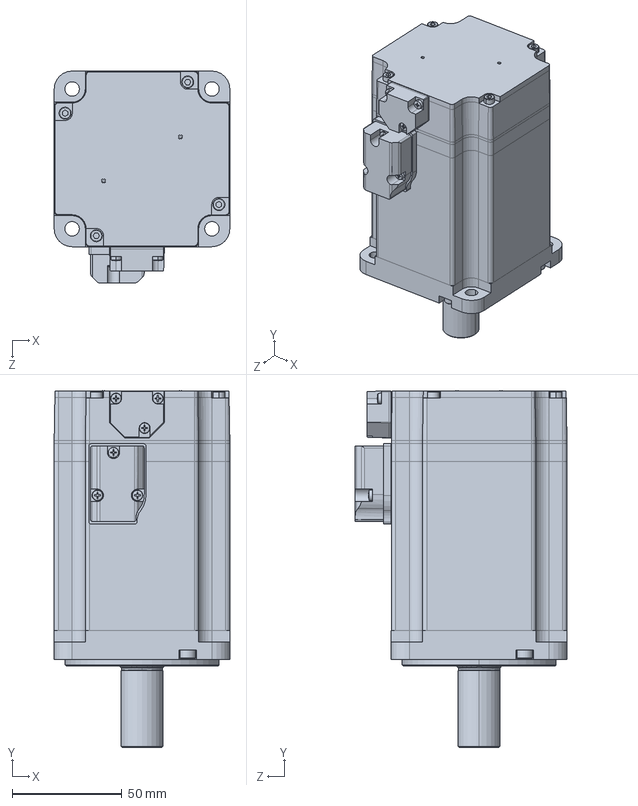
[picture p63: CAD file, 2023-01-25]
Modele3d/serwo hiwin.SLDPRT
80.0 x 162.5 x 96.5 mm
