j-glow/naped_manipulatora/(list of files, cad)

Other CAD files:
Modele3d/zl rysun nak.SLDASM
Modele3d/lozysko/SKF_30202_3.sldprt
sch_kin.SLDPRT
Modele3d/kolnierz.SLDPRT
Modele3d/lozysko/SKF_30202_5.sldprt
Modele3d/lozysko/SKF_30202_22.sldprt
Modele3d/lozysko/SKF_30202_20.sldprt
Modele3d/EKL_Size20.STEP
Modele3d/kołyska gora.SLDPRT
Modele3d/nakladka.SLDPRT
Modele3d/m5 16mm.SLDPRT
Modele3d/m6 16mm.SLDPRT
Modele3d/m6 20mm.SLDPRT
Modele3d/m6 30mm.SLDPRT
Modele3d/m6 45mm.SLDPRT
Rysunki/bok kolyski.SLDDRW
Rysunki/dolna pokrywa kolyski.SLDDRW
Rysunki/gorna pokrywa kolyski.SLDDRW
Rysunki/nakładka.SLDDRW
Rysunki/śruba.SLDDRW
full_assembly.SLDDRW
