j-glow/naped_manipulatora/PDF/PKR2-JG_00.00.pdf

4

3

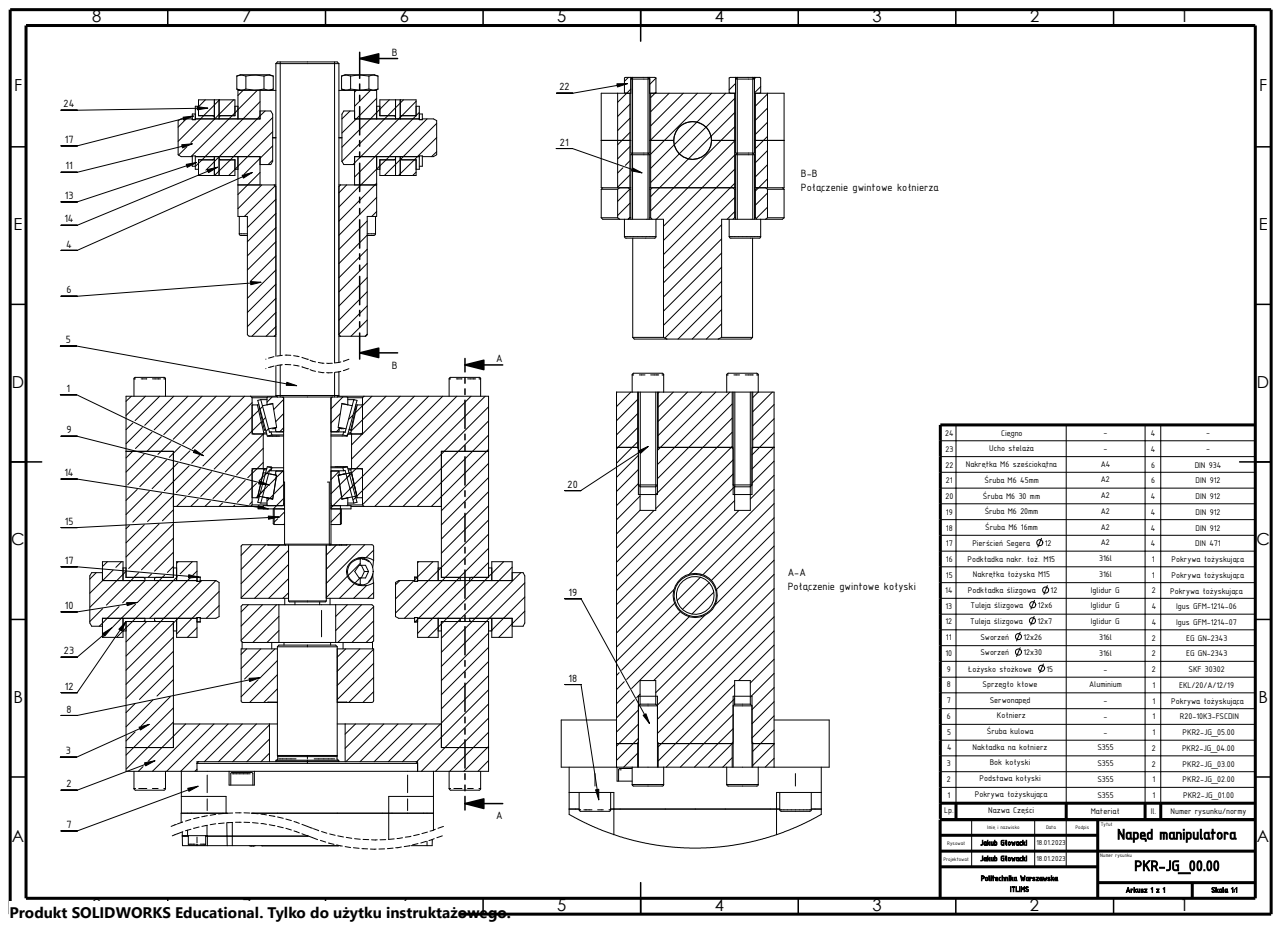
[picture p64: page 1]
ITLiMS; Arkusz 1 z 1; Skala 1:1; EKL/20/A/12/19; Politechnika Warszawska; Sprzęgło kłowe; Aluminium

Połączenie gwintowe kołnierza

24 4 | Cięgno | - -
23 | Ucho stelaża | - | 4 | -
22 | Nakrętka M6 sześciokątna | A4 | 6 | DIN 934
21 | Śruba M6 45mm | A2 | 6 | DIN 912
20 | Śruba M6 30 mm | A2 | 4 | DIN 912
19 | Śruba M6 20mm | A2 | 4 | DIN 912
18 | Śruba M6 16mm | A2 | 4 | DIN 912
17 | Pierścień Segera 12 | A2 | 4 | DIN 471
16 | Podkładka nakr. łoż. M15 | 316l | 1 | Pokrywa łożyskująca
15 1 | Nakrętka łożyska M15 | 316l | | Pokrywa łożyskująca
14 | Podkładka ślizgowa 12 | Iglidur G | 2 | Pokrywa łożyskująca
13 | Tuleja ślizgowa 12x6 | Iglidur G | 4 | Igus GFM-1214-06
12 | Tuleja ślizgowa 12x7 | Iglidur G | 4 | Igus GFM-1214-07
11 | Sworzeń 12x26 | 316l | 2 | EG GN-2343
10 | Sworzeń 12x30 | 316l | 2 | EG GN-2343
9 | Łożysko stożkowe 15 | - | 2 | SKF 30302

Połączenie gwintowe kołyski

7 | Serwonapęd | - | 1 | Pokrywa łożyskująca
6 | Kołnierz | - | 1 | R20-10K3-FSCDIN
5 | Śruba kulowa | - | 1 | PKR2-JG_05.00
4 | Nakładka na kołnierz | S355 | 2 | PKR2-JG_04.00
3 | Bok kołyski | S355 | 2 | PKR2-JG_03.00
2 | Podstawa kołyski | S355 | 1 | PKR2-JG_02.00
1 | Pokrywa łożyskująca | S355 | 1 | PKR2-JG_01.00
Lp. | Nazwa Części | Materiał | Il. | Numer rysunku/normy

Imię i nazwisko | Data | Podpis | Tytuł Napęd manipulatora

Rysował | Jakub Głowacki | 18.01.2023
Projektował | Jakub Głowacki | 18.01.2023 | | Numer rysunku PKR-JG_00.00

Produkt SOLIDWORKS Educational. Tylko do użytku instruktażowego.
