j-glow/naped_manipulatora/PDF/PKR2-JG_01.00.pdf

E E

F F

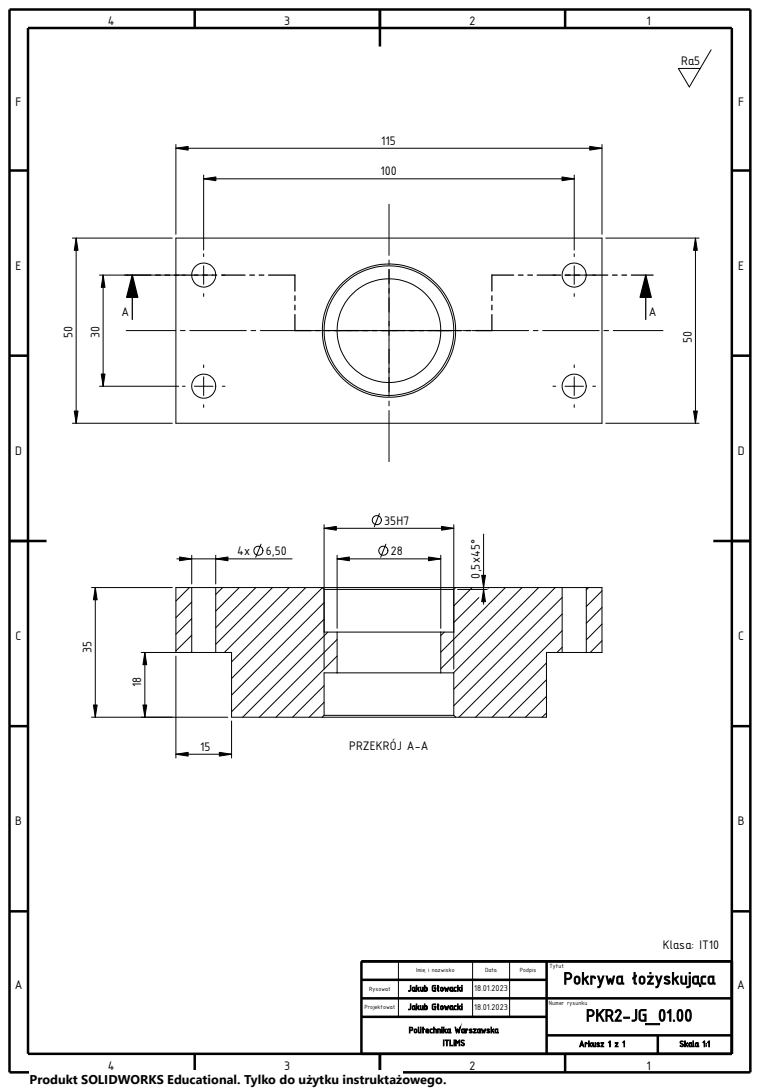
[picture p65: page 1]
Numer rysunku; Rysował; Projektował; Tytuł Imię i nazwisko; Data; Podpis; Jakub Głowacki; Arkusz 1 z 1; Skala 1:1; PKR2-JG_01.00; ITLiMS; Politechnika Warszawska; 15 PRZEKRÓJ A-A ³⁵; Klasa: IT10

Pokrywa łożyskująca ⁵⁰ ⁵⁰

Produkt SOLIDWORKS Educational. Tylko do użytku instruktażowego.
