j-glow/naped_manipulatora/PDF/PKR2-JG_02.00.pdf

E E

F F

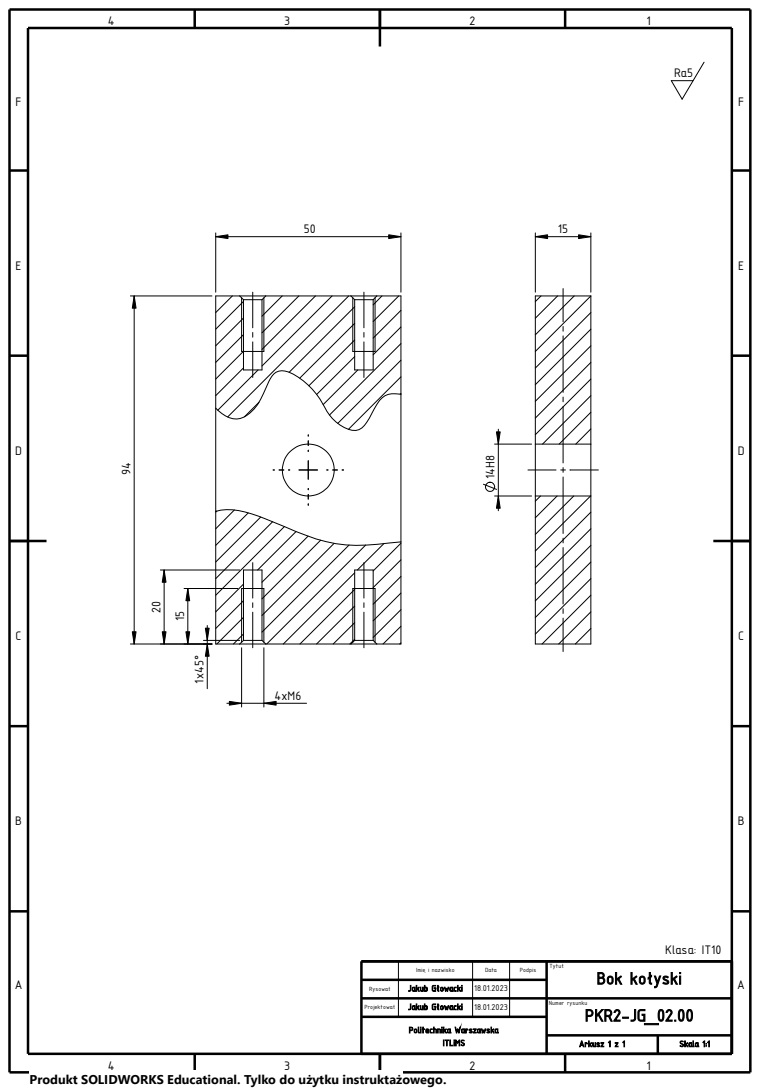
[picture p66: page 1]
Numer rysunku; Rysował; Projektował; Tytuł Imię i nazwisko; Data; Podpis; Jakub Głowacki; Arkusz 1 z 1; Skala 1:1; PKR2-JG_02.00; ITLiMS; Politechnika Warszawska; Bok kołyski; Klasa: IT10

Produkt SOLIDWORKS Educational. Tylko do użytku instruktażowego.
