j-glow/naped_manipulatora/PDF/PKR2-JG_03.00.pdf

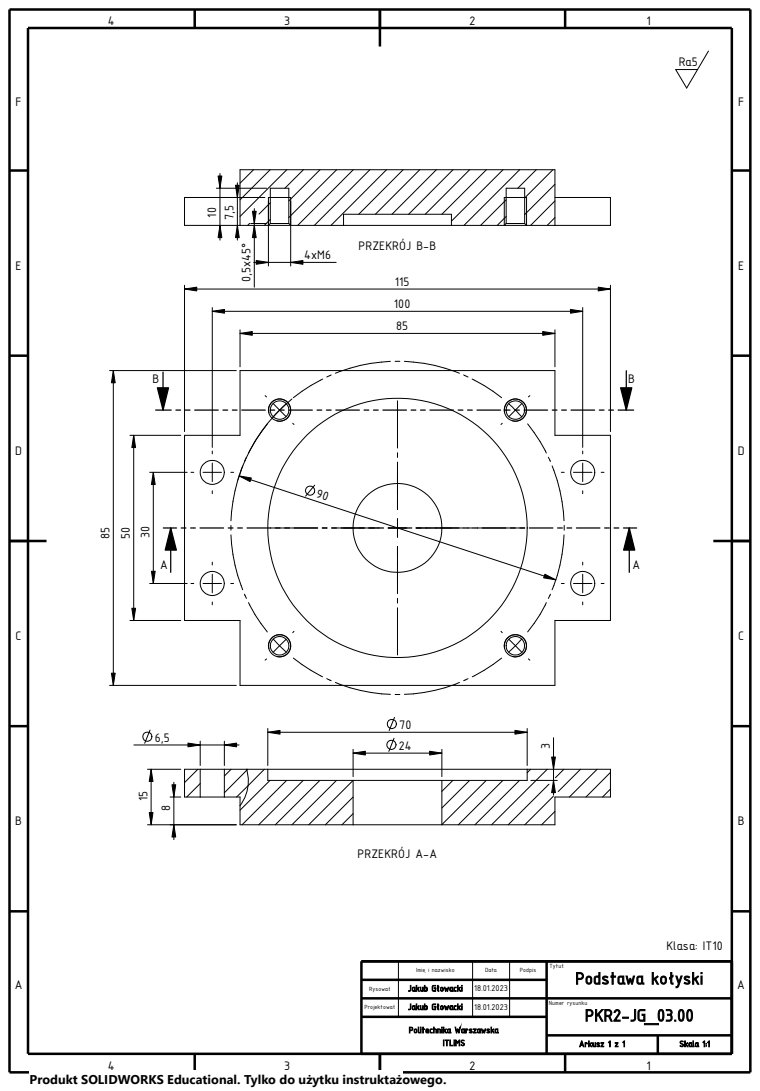
[picture p67: page 1]
Numer rysunku; Rysował; Projektował; Tytuł Imię i nazwisko; Data; Podpis; Jakub Głowacki; Arkusz 1 z 1; Skala 1:1; PKR2-JG_03.00; ITLiMS; Politechnika Warszawska; Podstawa kołyski; Klasa: IT10; PRZEKRÓJ B-B ¹⁰ 0,5x4⁵° 7,5; PRZEKRÓJ A-A ⁸

Produkt SOLIDWORKS Educational. Tylko do użytku instruktażowego.
