j-glow/naped_manipulatora/PDF/PKR2-JG_04.00.pdf

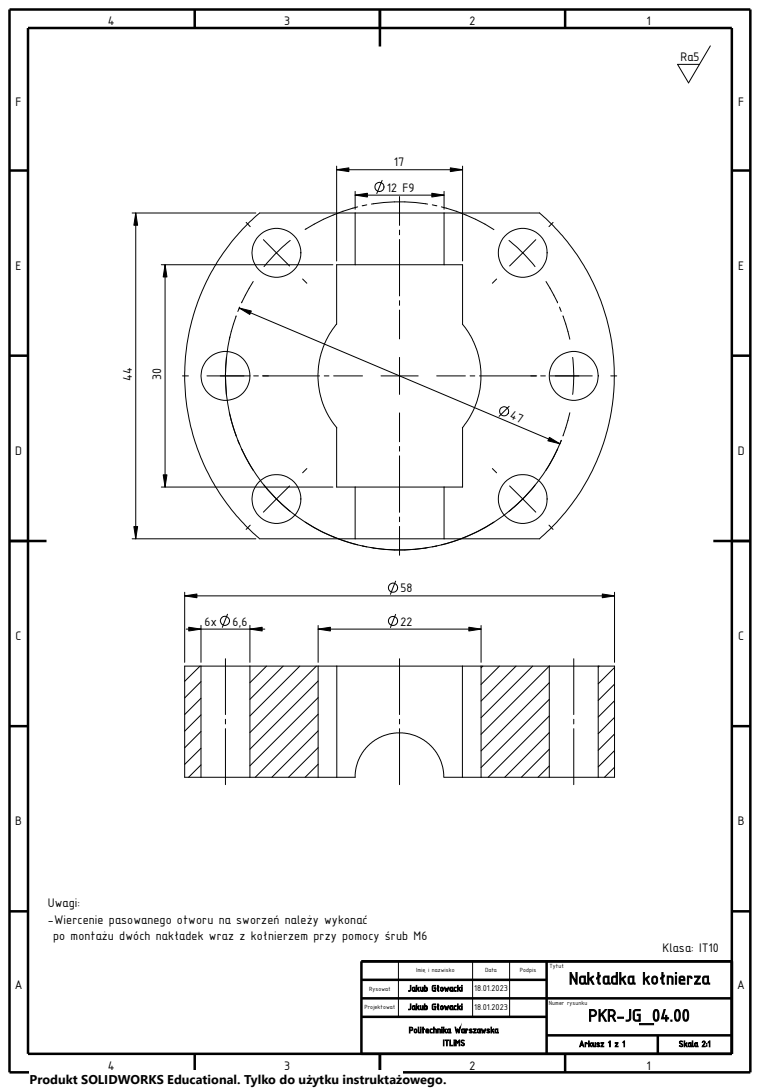
[picture p68: page 1]
ITLiMS; Skala 2:1; PKR-JG_04.00; Numer rysunku; Rysował; Projektował; Tytuł Imię i nazwisko; Data; Podpis; Jakub Głowacki; Arkusz 1 z 1; Politechnika Warszawska; Nakładka kołnierza; Klasa: IT10

Uwagi:
-Wiercenie pasowanego otworu na sworzeń należy wykonać
po montażu dwóch nakładek wraz z kołnierzem przy pomocy śrub M6

Produkt SOLIDWORKS Educational. Tylko do użytku instruktażowego.
